tschak909/frob-modern/hardware/docs/board-top.png

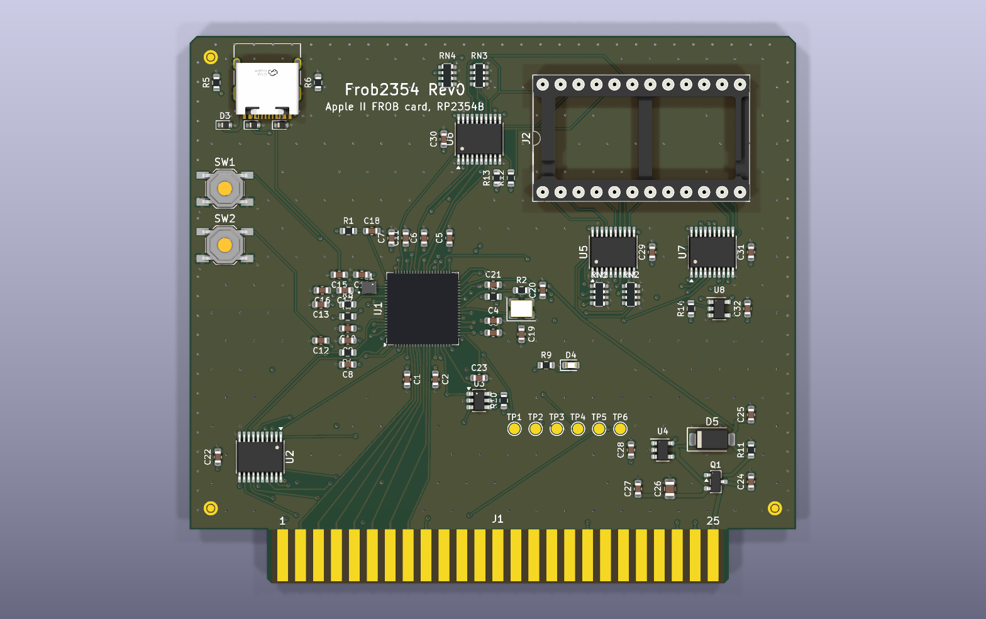
hardware/docs/board-top.png
