tschak909/frob-modern/hardware/docs/board-bottom.png

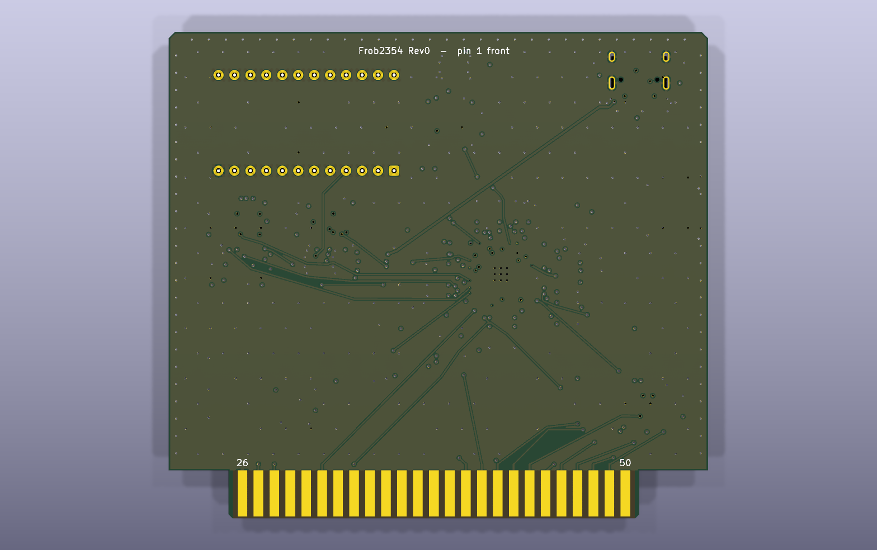
hardware/docs/board-bottom.png
