tschak909/frob-modern/hardware/Frob2354-BOM.csv

Refs | Value | Footprint | MPN | LCSC | Description | Assembly
C1,C2,C3,C4,C5,C6,C7,C8,C9,C10,C11,C14,C15,C16,C21,C22,C23,C24,C29,C30,C31,C32 | 100nF | C_0603_1608Metric | CC0603KRX7R9BB104 | C14663 | IOVDD decoupling | JLCPCB
C12,C28 | 10uF | C_0603_1608Metric | CL10A106KP8NNNC | C19702 | 3.3V bulk at the RP | JLCPCB
C13,C17,C18 | 4.7uF | C_0603_1608Metric | CL10A475KO8NNNC | C19666 | VREG_VIN bulk | JLCPCB
C19,C20 | 15pF | C_0603_1608Metric | CL10C150JB8NNNC | C1644 | crystal load | JLCPCB
C25,C27 | 1uF | C_0603_1608Metric | CL10A105KB8NNNC | C15849 | VBUS decoupling | JLCPCB
C26 | 22uF | C_0805_2012Metric | CL21A226MAQNNNE | C45783 | +5V bulk | JLCPCB
D1,D2,D3 | ESD5Z5.0T1G | D_SOD-523 | ESD5Z5.0T1G | C82044 | USB ESD | JLCPCB
D4 | green | LED_0603_1608Metric | KT-0603G | C12624 | status LED (GP22) | JLCPCB
D5 | SS34 | D_SMA | SS34 | C8678 | USB VBUS OR-ing (no back-feed into the Apple) | JLCPCB
J2 | FROB cable | DIP-24_W15.24mm_Socket | 110-43-624-41-001000 |  | 2600 cable socket, DIP-24 0.6 in (original FROB J2 pin-out); hand-solder | hand-solder
J3 | USB-C | USB_C_Receptacle_HRO_TYPE-C-31-M-12 | TYPE-C-31-M-12 | C165948 | firmware update / bench power | JLCPCB
L1 | 3.3uH | RPI_L_AOTA-B201610S3R3 | AOTA-B201610S3R3-101-T | C42411119 | RP2350 core SMPS inductor | JLCPCB
Q1 | AO3401A | SOT-23 | AO3401A | C15127 | slot 5V switch: G = VBUS, S = +5V, D = SLOT_5V | JLCPCB
R1 | 33R | R_0603_1608Metric | 0603WAF330JT5E | C23140 | VREG_AVDD filter | JLCPCB
R2,R4,R9 | 1k | R_0603_1608Metric | 0603WAF1001T5E | C21190 | crystal drive limit | JLCPCB
R3,R10,R12,R13,R14 | 10k | R_0603_1608Metric | 0603WAF1002T5E | C25804 | RUN pull-up | JLCPCB
R5,R6 | 5.1k | R_0603_1608Metric | 0603WAF5101T5E | C23186 | UFP Rd | JLCPCB
R7,R8 | 27R | R_0603_1608Metric | 0603WAF270JT5E | C25190 | USB series | JLCPCB
R11 | 100k | R_0603_1608Metric | 0603WAF1003T5E | C25803 | holds the P-FET gate low without USB | JLCPCB
RN1,RN2,RN3,RN4 | 4x100k | R_Array_Convex_4x0603 | 4D03WGJ0104T5E | C1996 | 2600 address pull-downs: defined inputs with the cable unplugged | JLCPCB
SW1 | RESET | SW_SPST_TL3342 | TL3342F160QG | C2886898 | RP2354B reset (RUN) | JLCPCB
SW2 | BOOTSEL | SW_SPST_TL3342 | TL3342F160QG | C2886898 | RP2354B BOOTSEL: hold while pressing RESET (or plugging USB) for the UF2 drive | JLCPCB
U1 | RP2354B | QFN-80-1EP_10x10mm_P0.4mm_EP3.4x3.4mm | RP2354B | C39843328 | RP2350B + 2MB flash: FROB RAM, control/status and mailbox registers, both buses | JLCPCB
U2,U5,U6,U7 | 74LVC245A | TSSOP-20_4.4x6.5mm_P0.65mm | SN74LVC245APWR | C7848 | Apple D0-D7 buffer: DIR = R/W, enabled only during this slot's /IOSEL or /DEVSEL | JLCPCB
U3 | 74LVC1G0832 | SOT-23-6 | SN74LVC1G0832DBVR | C206101 | Apple buffer /OE = (/IOSEL & /DEVSEL) | A2_DOE_N | JLCPCB
U4 | AP2112K-3.3 | SOT-23-5 | AP2112K-3.3TRG1 | C51118 | 3.3V LDO, 600mA, fast start: every 3.3V load | JLCPCB
U8 | 74LVC1G32 | SOT-23-5 | SN74LVC1G32DBVR | C10096 | 2600 data buffer /OE = /CE | V_DOE_N | JLCPCB
Y1 | 12MHz | Crystal_SMD_3225-4Pin_3.2x2.5mm | ABM8-272-T3 | C20625731 |  | JLCPCB
