tschak909/frob-modern/hardware/3d/C_0805_2012Metric.step

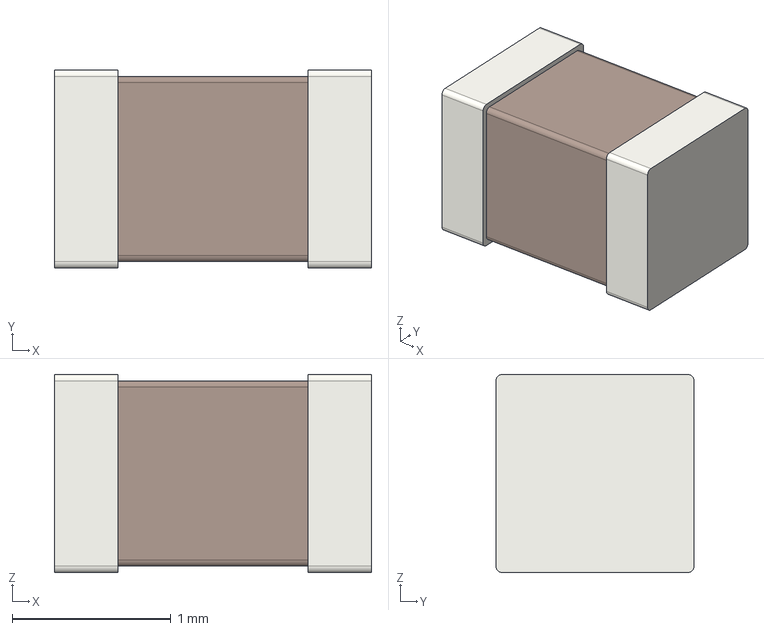
[picture p3: CAD file, 2026-10-03]
hardware/3d/C_0805_2012Metric.step
2.00 x 1.25 x 1.25 mm
