tschak909/frob-modern/hardware/3d/D_SMA.step

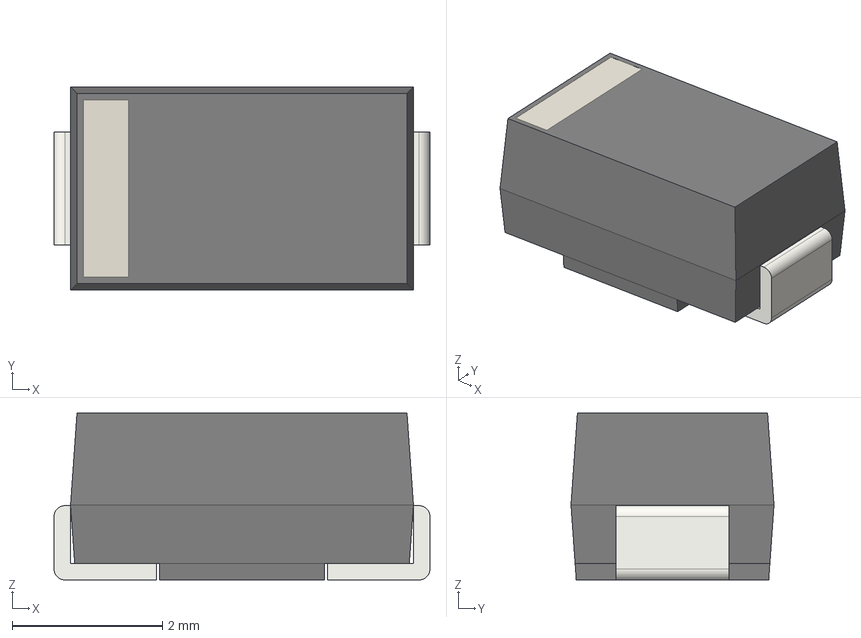
[picture p4: CAD file, 2026-10-03]
hardware/3d/D_SMA.step
5.00 x 2.70 x 2.22 mm
