tschak909/frob-modern/hardware/3d/DIP-24_W15.24mm_Socket.step

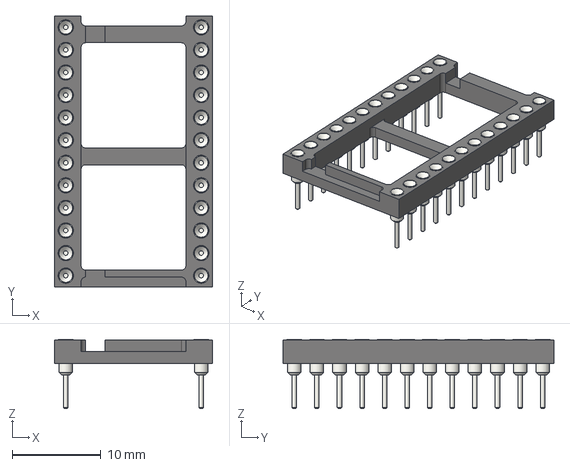
[picture p5: CAD file, 2026-10-03]
hardware/3d/DIP-24_W15.24mm_Socket.step
17.8 x 30.5 x 7.79 mm
