tschak909/frob-modern/hardware/3d/SOT-23.step

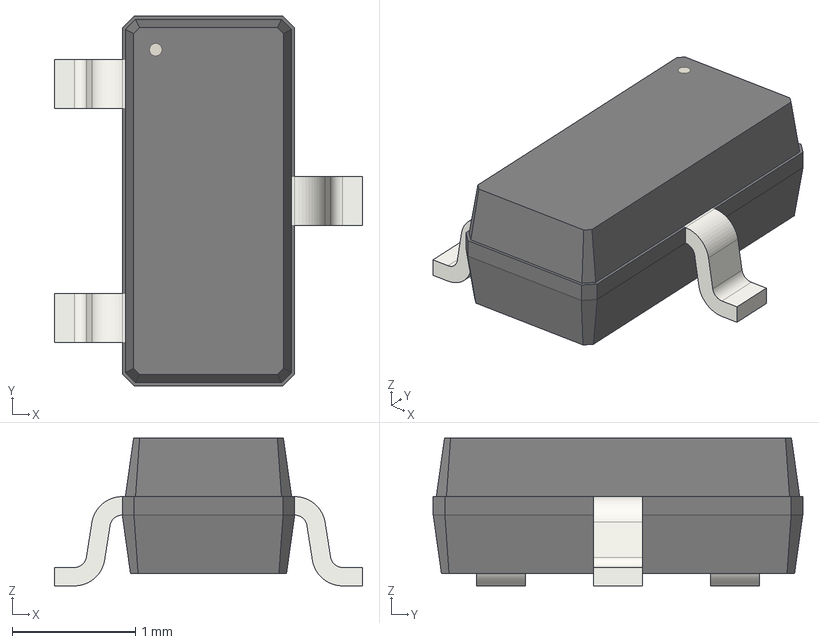
[picture p6: CAD file, 2026-10-03]
hardware/3d/SOT-23.step
2.50 x 3.00 x 1.20 mm
