tschak909/frob-modern/hardware/3d/R_Array_Convex_4x0603.step

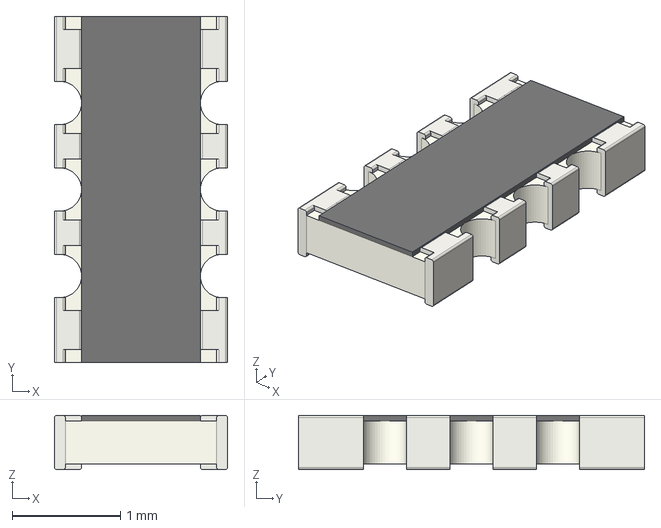
[picture p7: CAD file, 2026-10-03]
hardware/3d/R_Array_Convex_4x0603.step
1.60 x 3.20 x 0.5 mm
