tschak909/frob-modern/hardware/3d/SW_SPST_TL3342.step

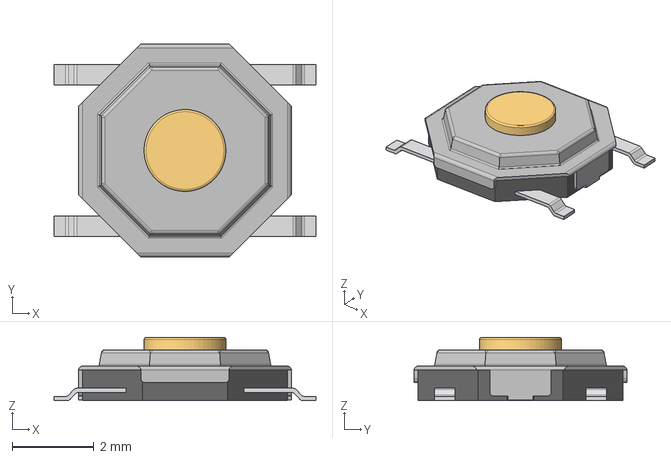
[picture p9: CAD file, 2026-10-03]
hardware/3d/SW_SPST_TL3342.step
6.40 x 5.20 x 1.54 mm
