tschak909/frob-modern/hardware/3d/USB-C_HRO_TYPE-C-31-M-12.step

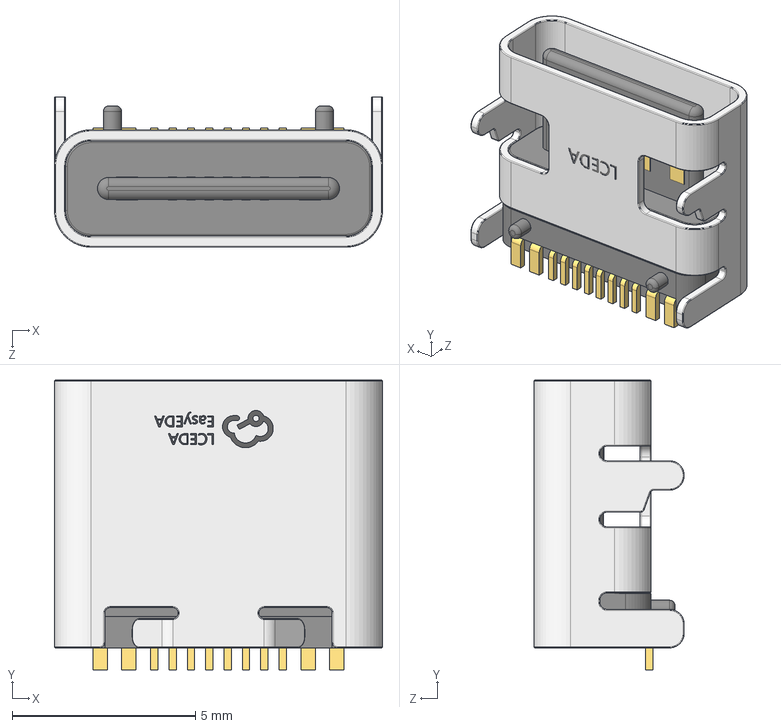
[picture p10: CAD file, 2026-10-03]
hardware/3d/USB-C_HRO_TYPE-C-31-M-12.step
8.94 x 7.90 x 4.10 mm
