tschak909/frob-modern/hardware/3d/R_0603_1608Metric.step

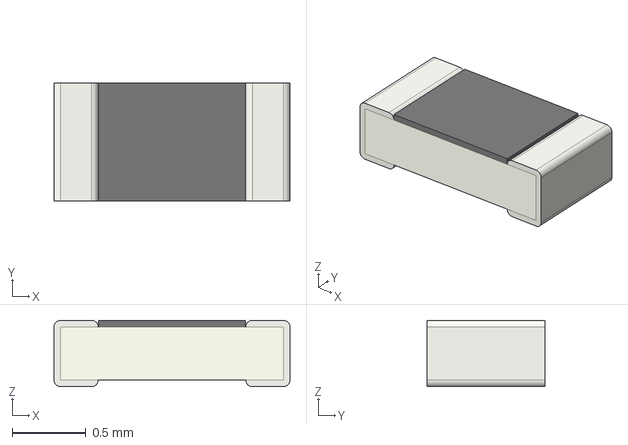
[picture p11: CAD file, 2026-10-03]
hardware/3d/R_0603_1608Metric.step
1.60 x 0.8 x 0.45 mm
