tschak909/frob-modern/hardware/3d/SOT-23-6.step

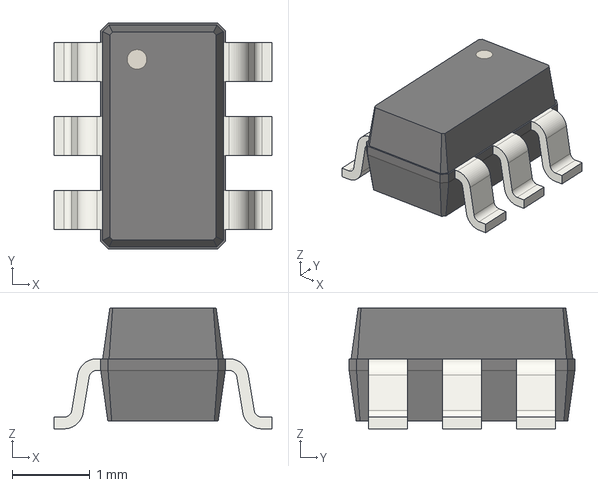
[picture p12: CAD file, 2026-10-03]
hardware/3d/SOT-23-6.step
2.80 x 2.90 x 1.55 mm
