tschak909/frob-modern/hardware/3d/TSSOP-20_4.4x6.5mm_P0.65mm.step

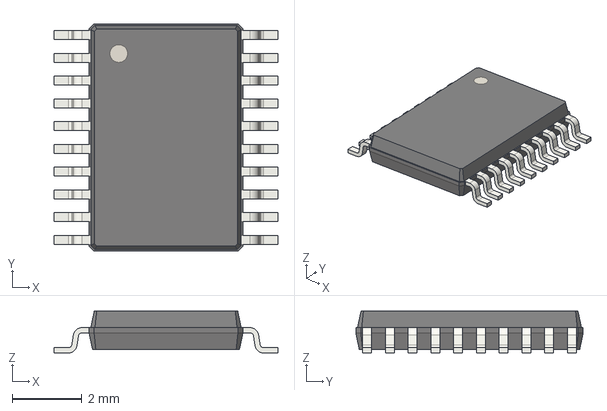
[picture p13: CAD file, 2026-10-03]
hardware/3d/TSSOP-20_4.4x6.5mm_P0.65mm.step
6.40 x 6.50 x 1.20 mm
