tschak909/frob-modern/hardware/3d/SOT-23-5.step

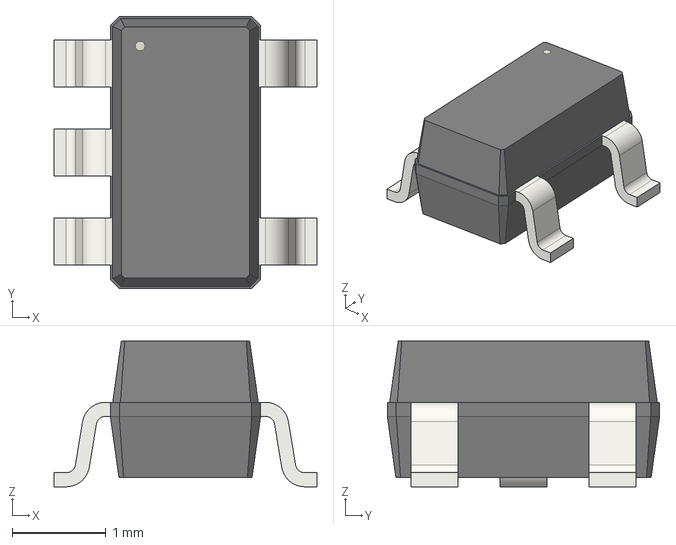
[picture p14: CAD file, 2026-10-03]
hardware/3d/SOT-23-5.step
2.80 x 2.90 x 1.55 mm
