tschak909/frob-modern/hardware/3d/AOTA-B201610S3R3.step

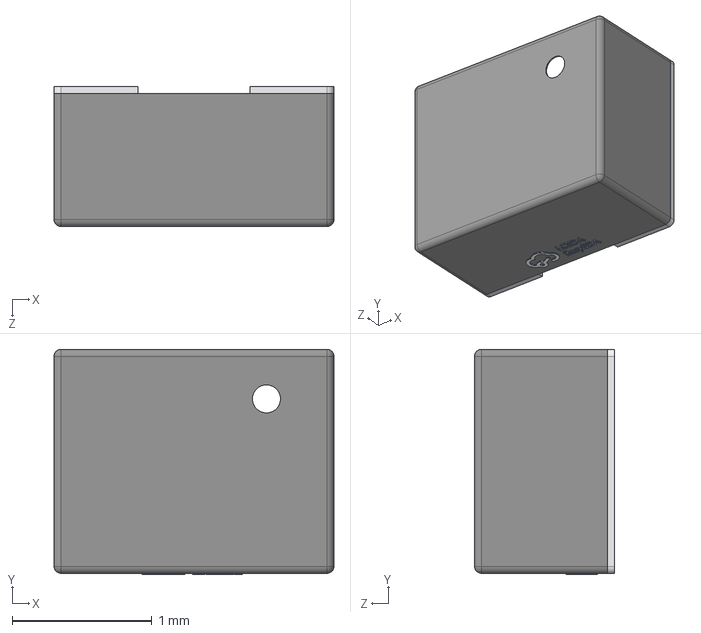
[picture p15: CAD file, 2026-10-03]
hardware/3d/AOTA-B201610S3R3.step
2.00 x 1.61 x 1.00 mm
