tschak909/frob-modern/hardware/3d/LED_0603_1608Metric.step

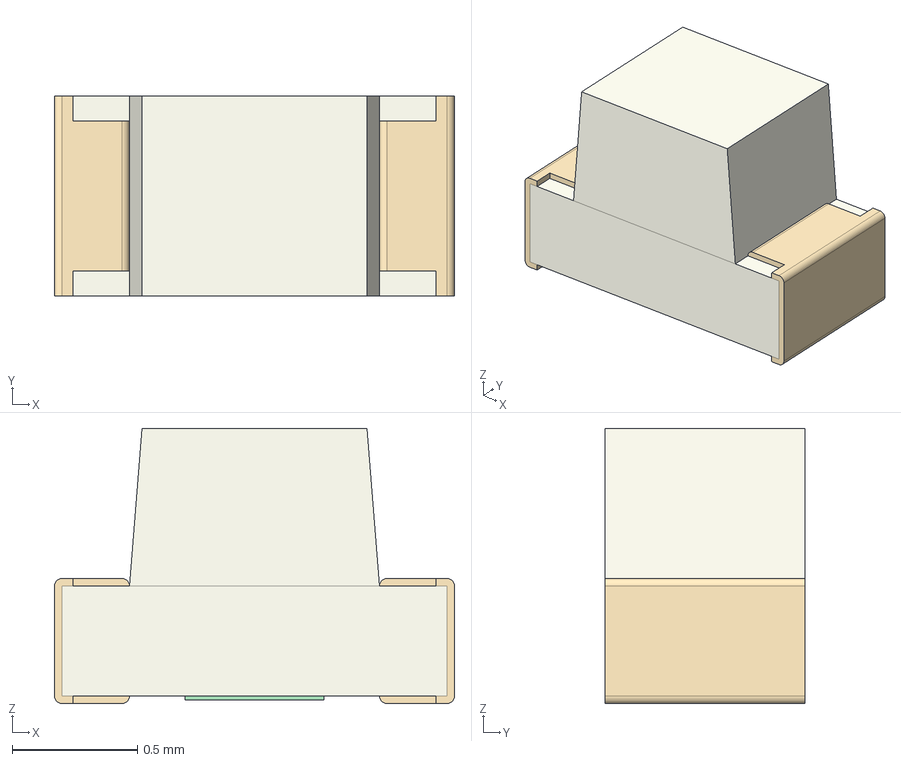
[picture p16: CAD file, 2026-10-03]
hardware/3d/LED_0603_1608Metric.step
1.60 x 0.8 x 1.10 mm
