tschak909/frob-modern/hardware/3d/D_SOD-523.step

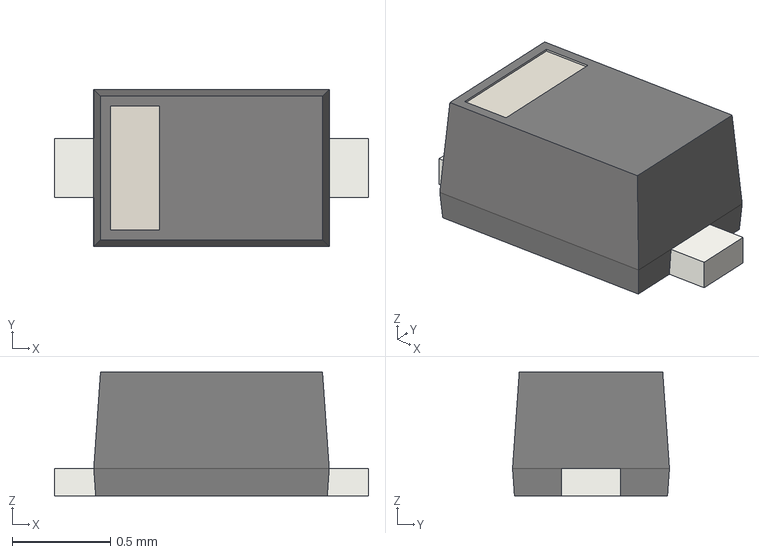
[picture p17: CAD file, 2026-10-03]
hardware/3d/D_SOD-523.step
1.60 x 0.8 x 0.63 mm
