tschak909/frob-modern/hardware/3d/Crystal_SMD_3225-4Pin_3.2x2.5mm.step

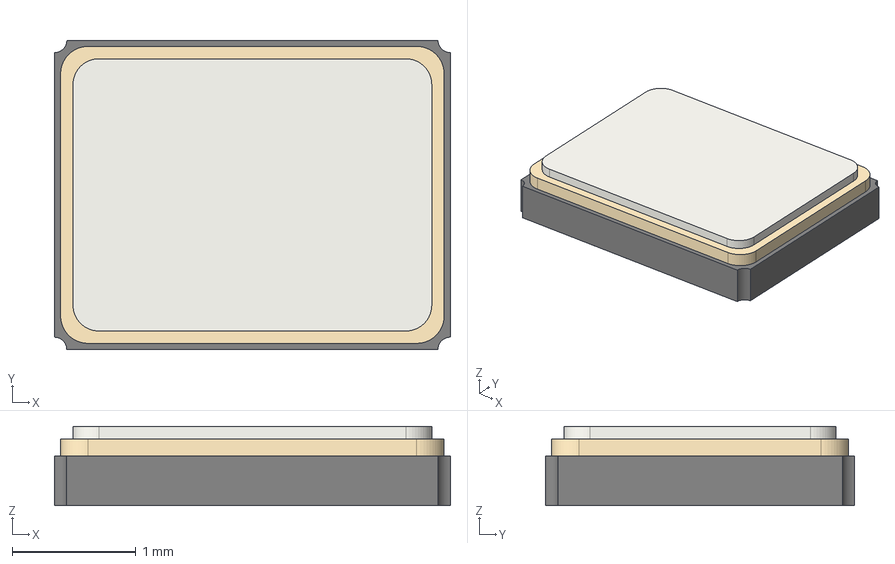
[picture p18: CAD file, 2026-10-03]
hardware/3d/Crystal_SMD_3225-4Pin_3.2x2.5mm.step
3.20 x 2.50 x 0.64 mm
