tschak909/frob-modern/hardware/docs/Frob2354-schematic.pdf

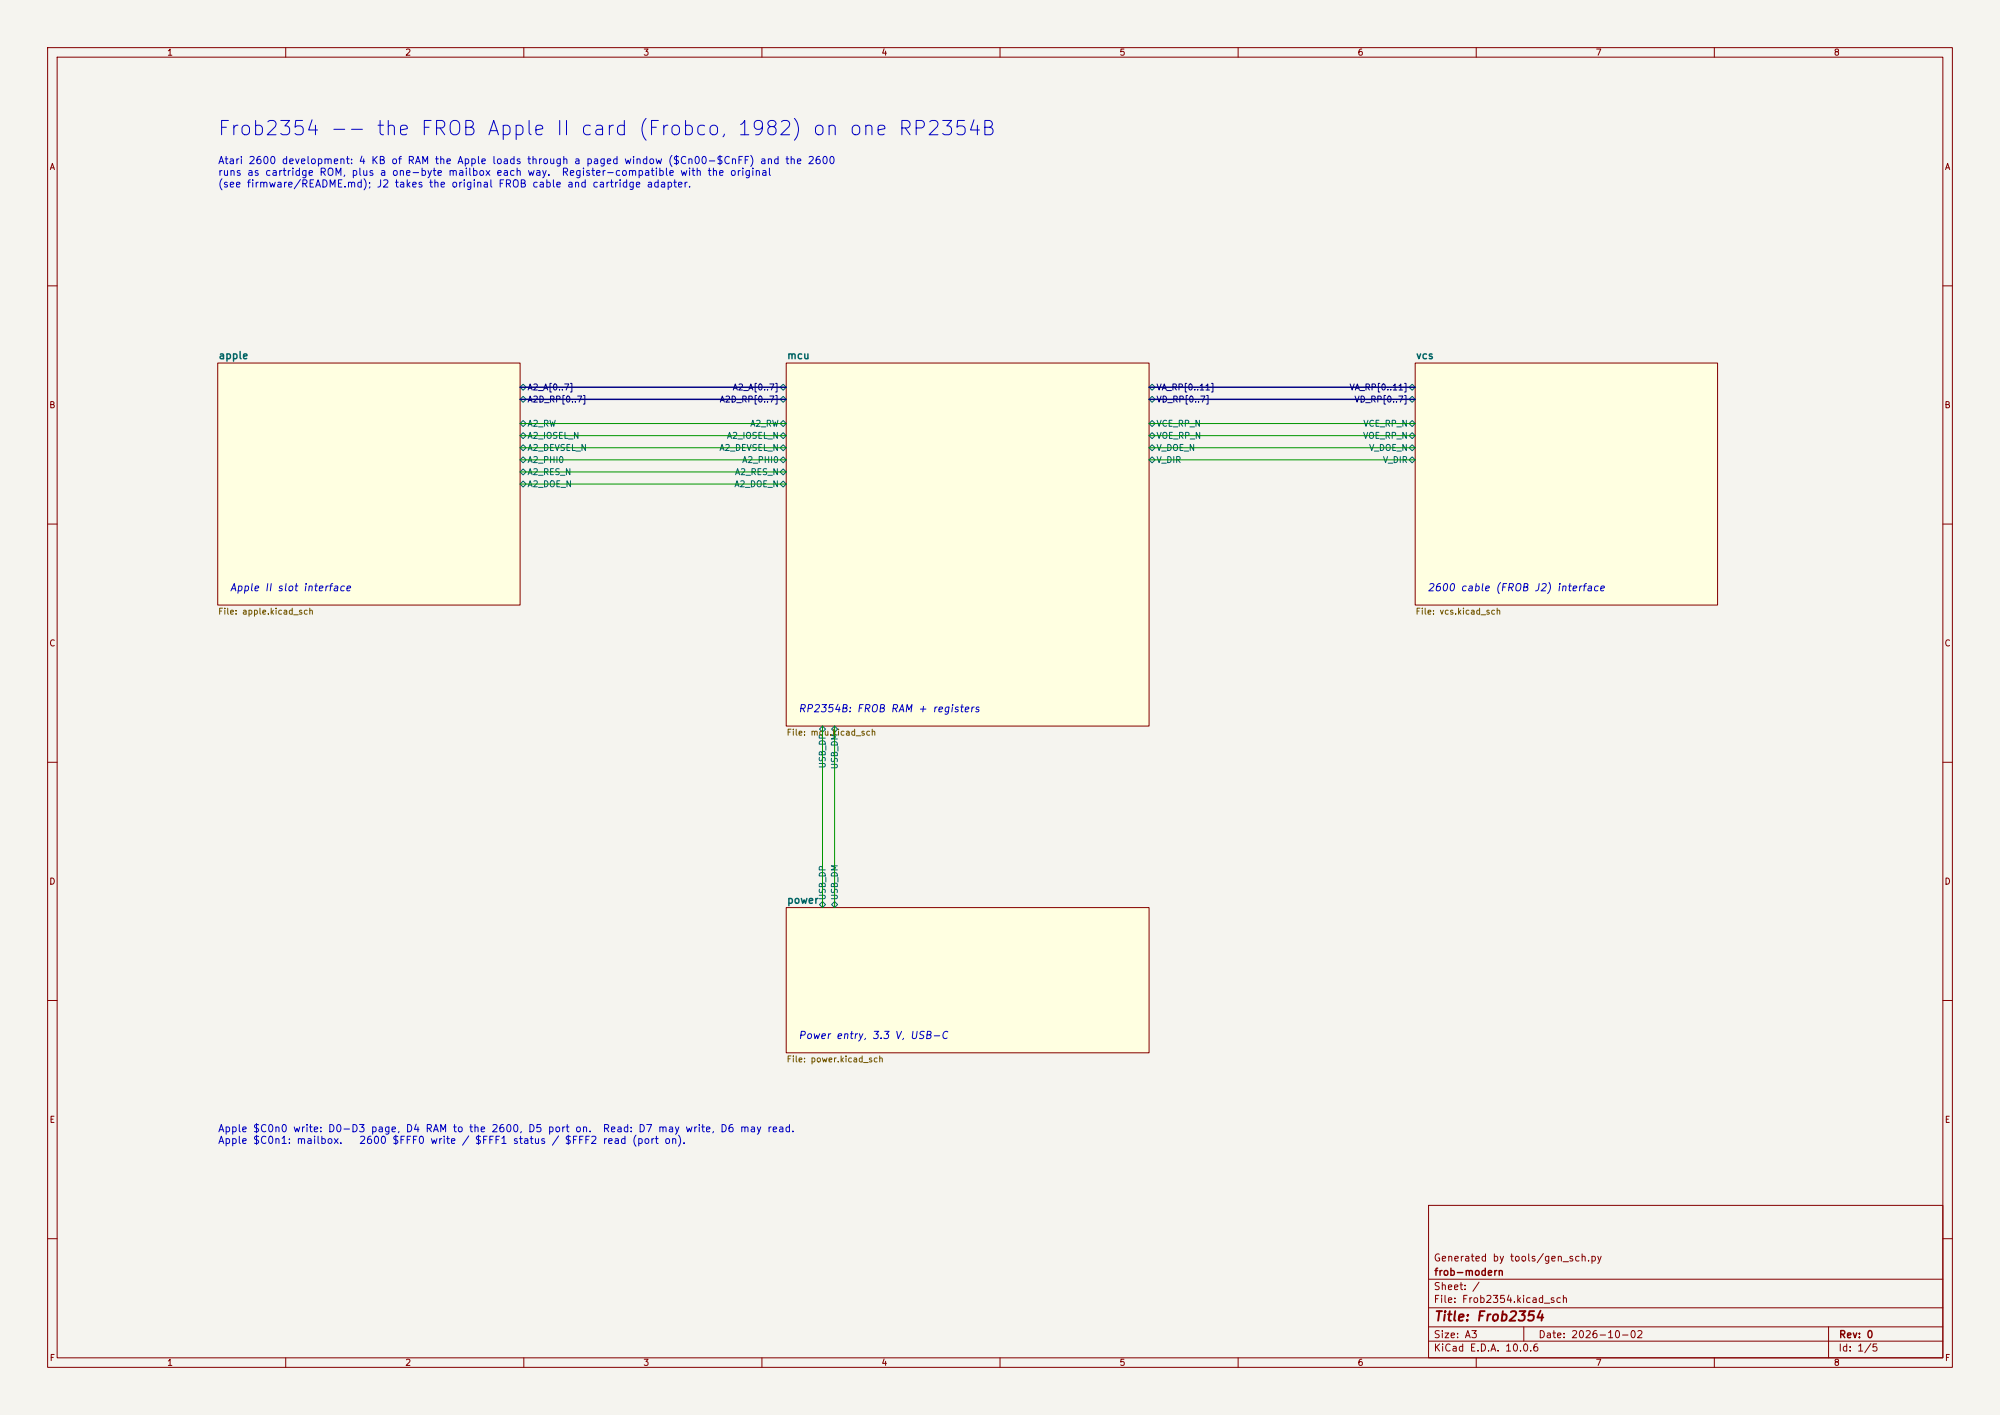
[picture p19: page 1]

Frob2354 -- the FROB Apple II card (Frobco, 1982) on one RP2354B

Atari 2600 development: 4 KB of RAM the Apple loads through a paged window ($Cn00-$CnFF) and the 2600
runs as cartridge ROM, plus a one-byte mailbox each way. Register-compatible with the original
(see firmware/README.md); J2 takes the original FROB cable and cartridge adapter.

A2D_RP[0..7] A2_RW | VD_RP[0..7] VCE_RP_N

A2_IOSEL_N | VOE_RP_N
A2_DEVSEL_N A2_DEVSEL_N A2_PHI0 A2_PHI0 | V_DOE_N

RP2354B: FROB RAM + registers
File: mcu.kicad_sch USB_DP USB_DM power File: power.kicad_sch

Apple $C0n0 write: D0-D3 page, D4 RAM to the 2600, D5 port on. Read: D7 may write, D6 may read.

Size: A3 | Rev: 0 | F Date: 2026-10-02
KiCad E.D.A. 10.0.6 | Id: 1/5

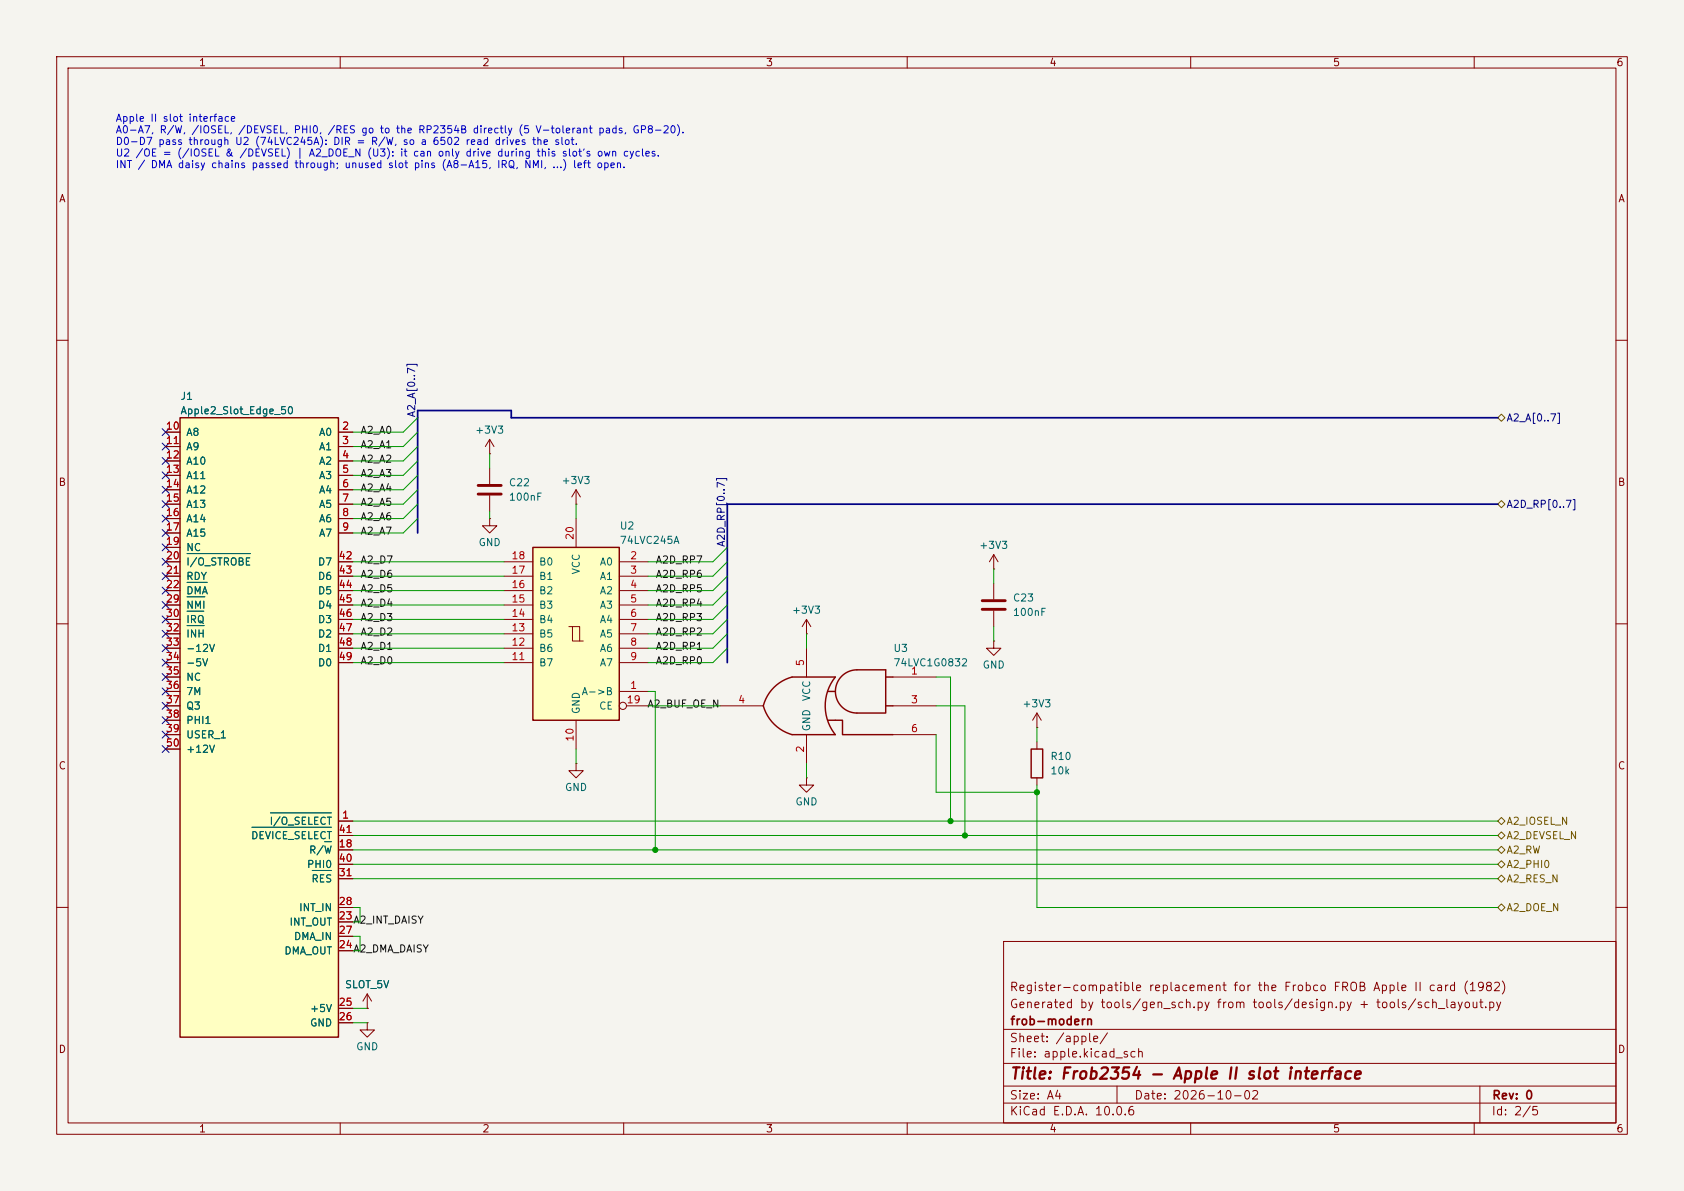
[picture p20: page 2]

Apple II slot interface
A0-A7, R/W, /IOSEL, /DEVSEL, PHI0, /RES go to the RP2354B directly (5 V-tolerant pads, GP8-20). D0-D7 pass through U2 (74LVC245A): DIR = R/W, so a 6502 read drives the slot. U2 /OE = (/IOSEL & /DEVSEL) | A2_DOE_N (U3): it can only drive during this slot's own cycles.

INT / DMA daisy chains passed through; unused slot pins (A8-A15, IRQ, NMI, ...) left open. J1

Register-compatible replacement for the Frobco FROB Apple II card (1982) C23

Generated by tools/gen_sch.py from tools/design.py + tools/sch_layout.py
frob-modern
Sheet: /apple/
File: apple.kicad_sch
Title: Frob2354 - Apple II slot interface

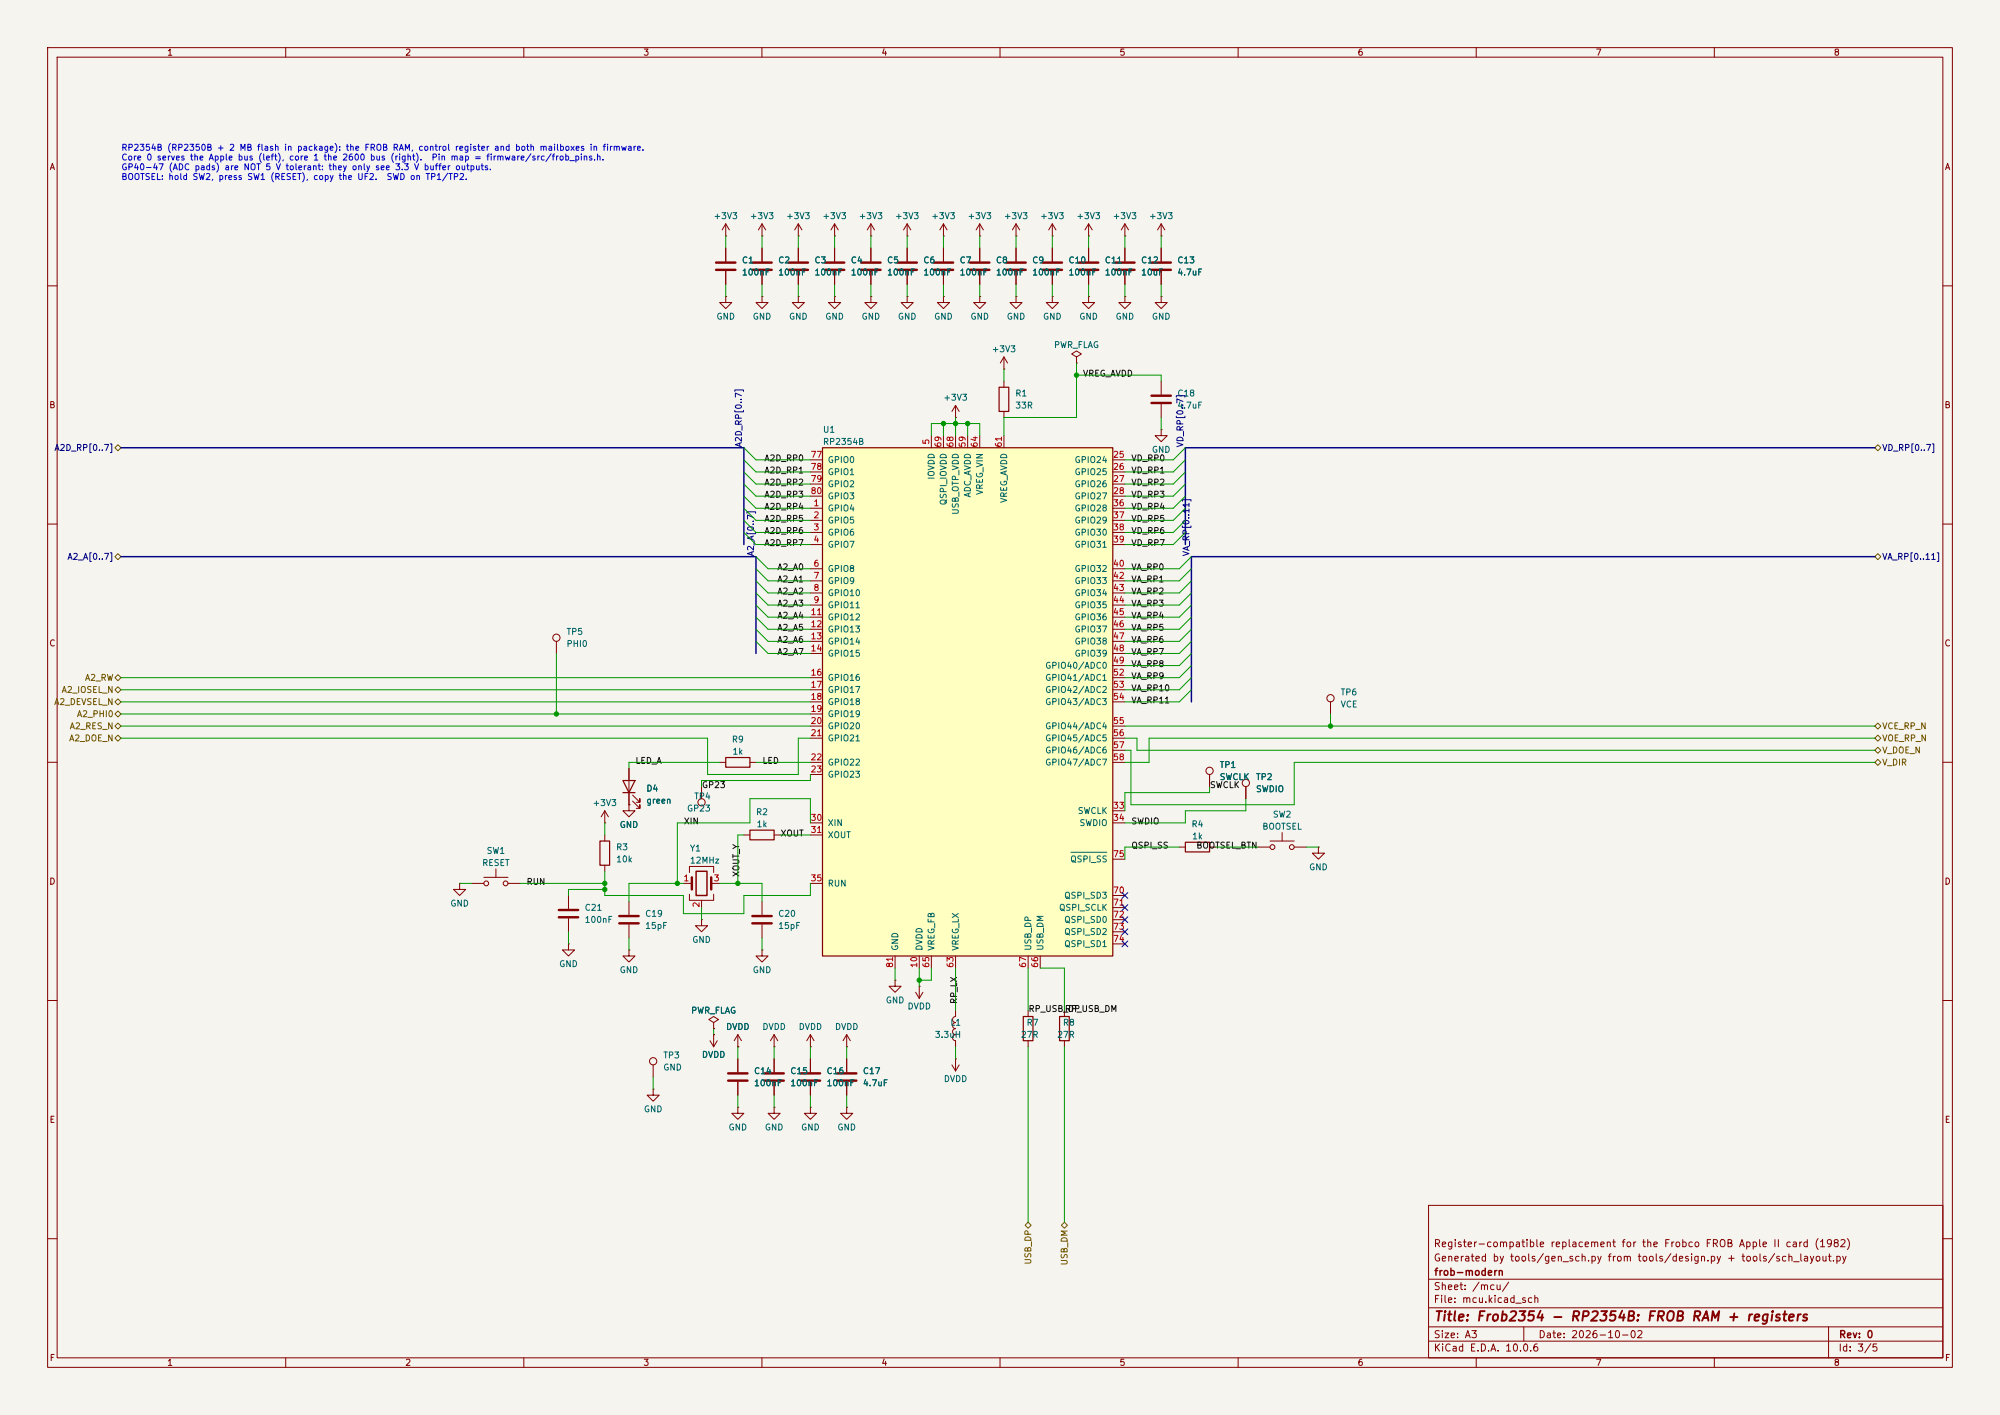
[picture p21: page 3]

A2D_RP5 RP2354B (RP2350B + 2 MB flash in package): the FROB RAM, control register and both mailboxes in firmware. Core 0 serves the Apple bus (left), core 1 the 2600 bus (right). Pin map = firmware/src/frob_pins.h. GP40-47 (ADC pads) are NOT 5 V tolerant: they only see 3.3 V buffer outputs. BOOTSEL: hold SW2, press SW1 (RESET), copy the UF2. SWD on TP1/TP2.

Register-compatible replacement for the Frobco FROB Apple II card (1982) GND
DVDD

Generated by tools/gen_sch.py from tools/design.py + tools/sch_layout.py
frob-modern
Sheet: /mcu/
File: mcu.kicad_sch
Title: Frob2354 - RP2354B: FROB RAM + registers

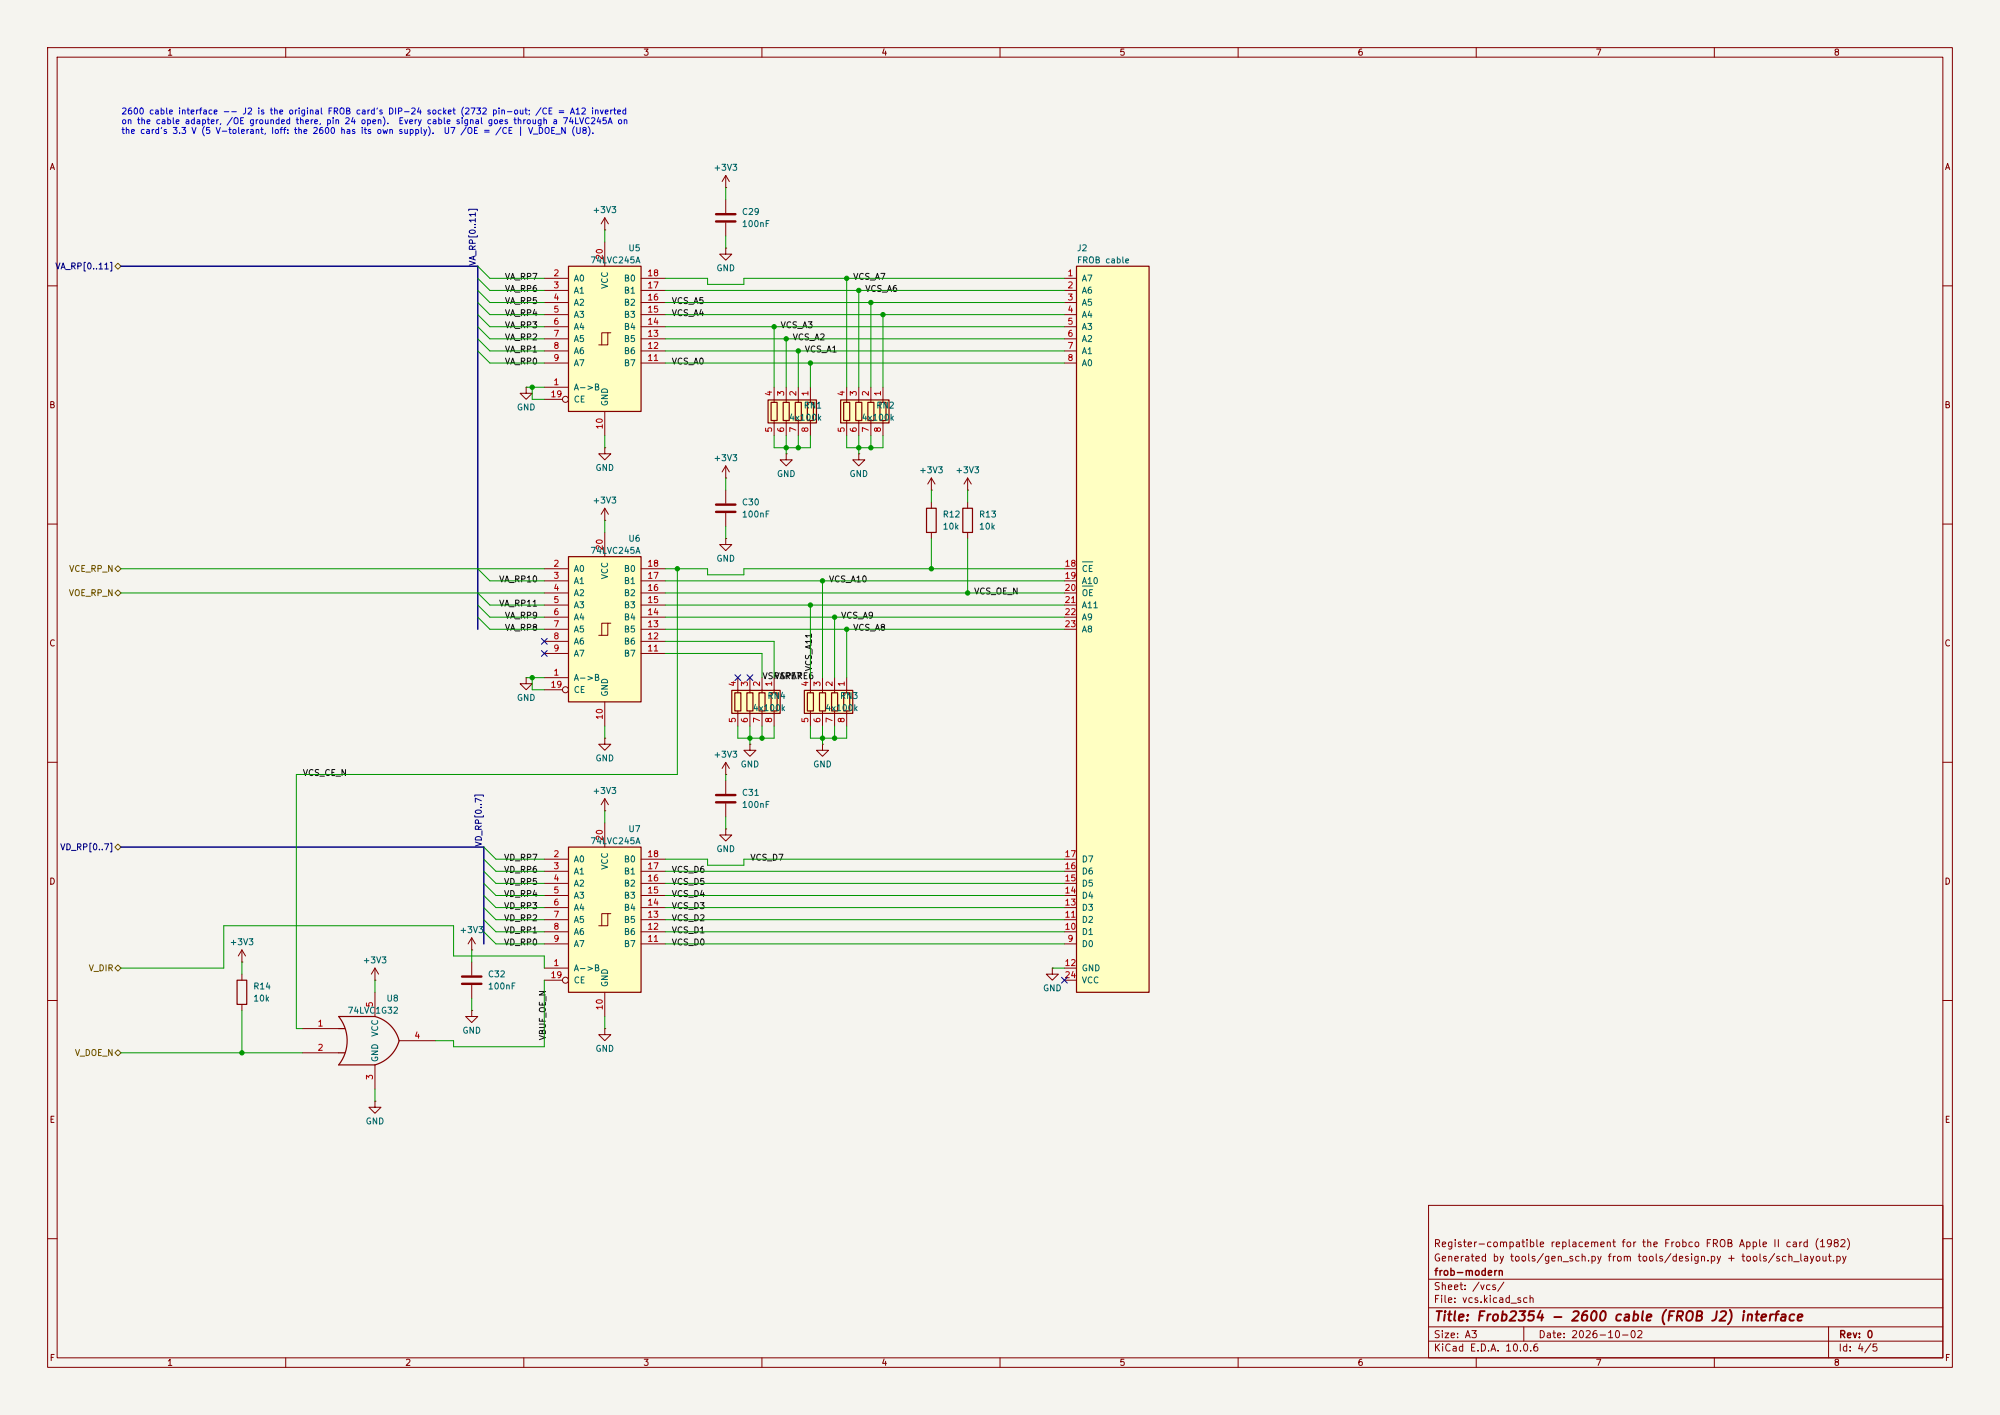
[picture p22: page 4]

2600 cable interface -- J2 is the original FROB card's DIP-24 socket (2732 pin-out; /CE = A12 inverted
on the cable adapter, /OE grounded there, pin 24 open). Every cable signal goes through a 74LVC245A on
the card's 3.3 V (5 V-tolerant, Ioff: the 2600 has its own supply). U7 /OE = /CE | V_DOE_N (U8).

FROB cable R13 A1 7

VCS_A5 | A5 3
VCS_A4 | | A4 4

A3 5
A2 6

74LVC1G32
Register-compatible replacement for the Frobco FROB Apple II card (1982) 1

Generated by tools/gen_sch.py from tools/design.py + tools/sch_layout.py
frob-modern
Sheet: /vcs/
File: vcs.kicad_sch
Title: Frob2354 - 2600 cable (FROB J2) interface

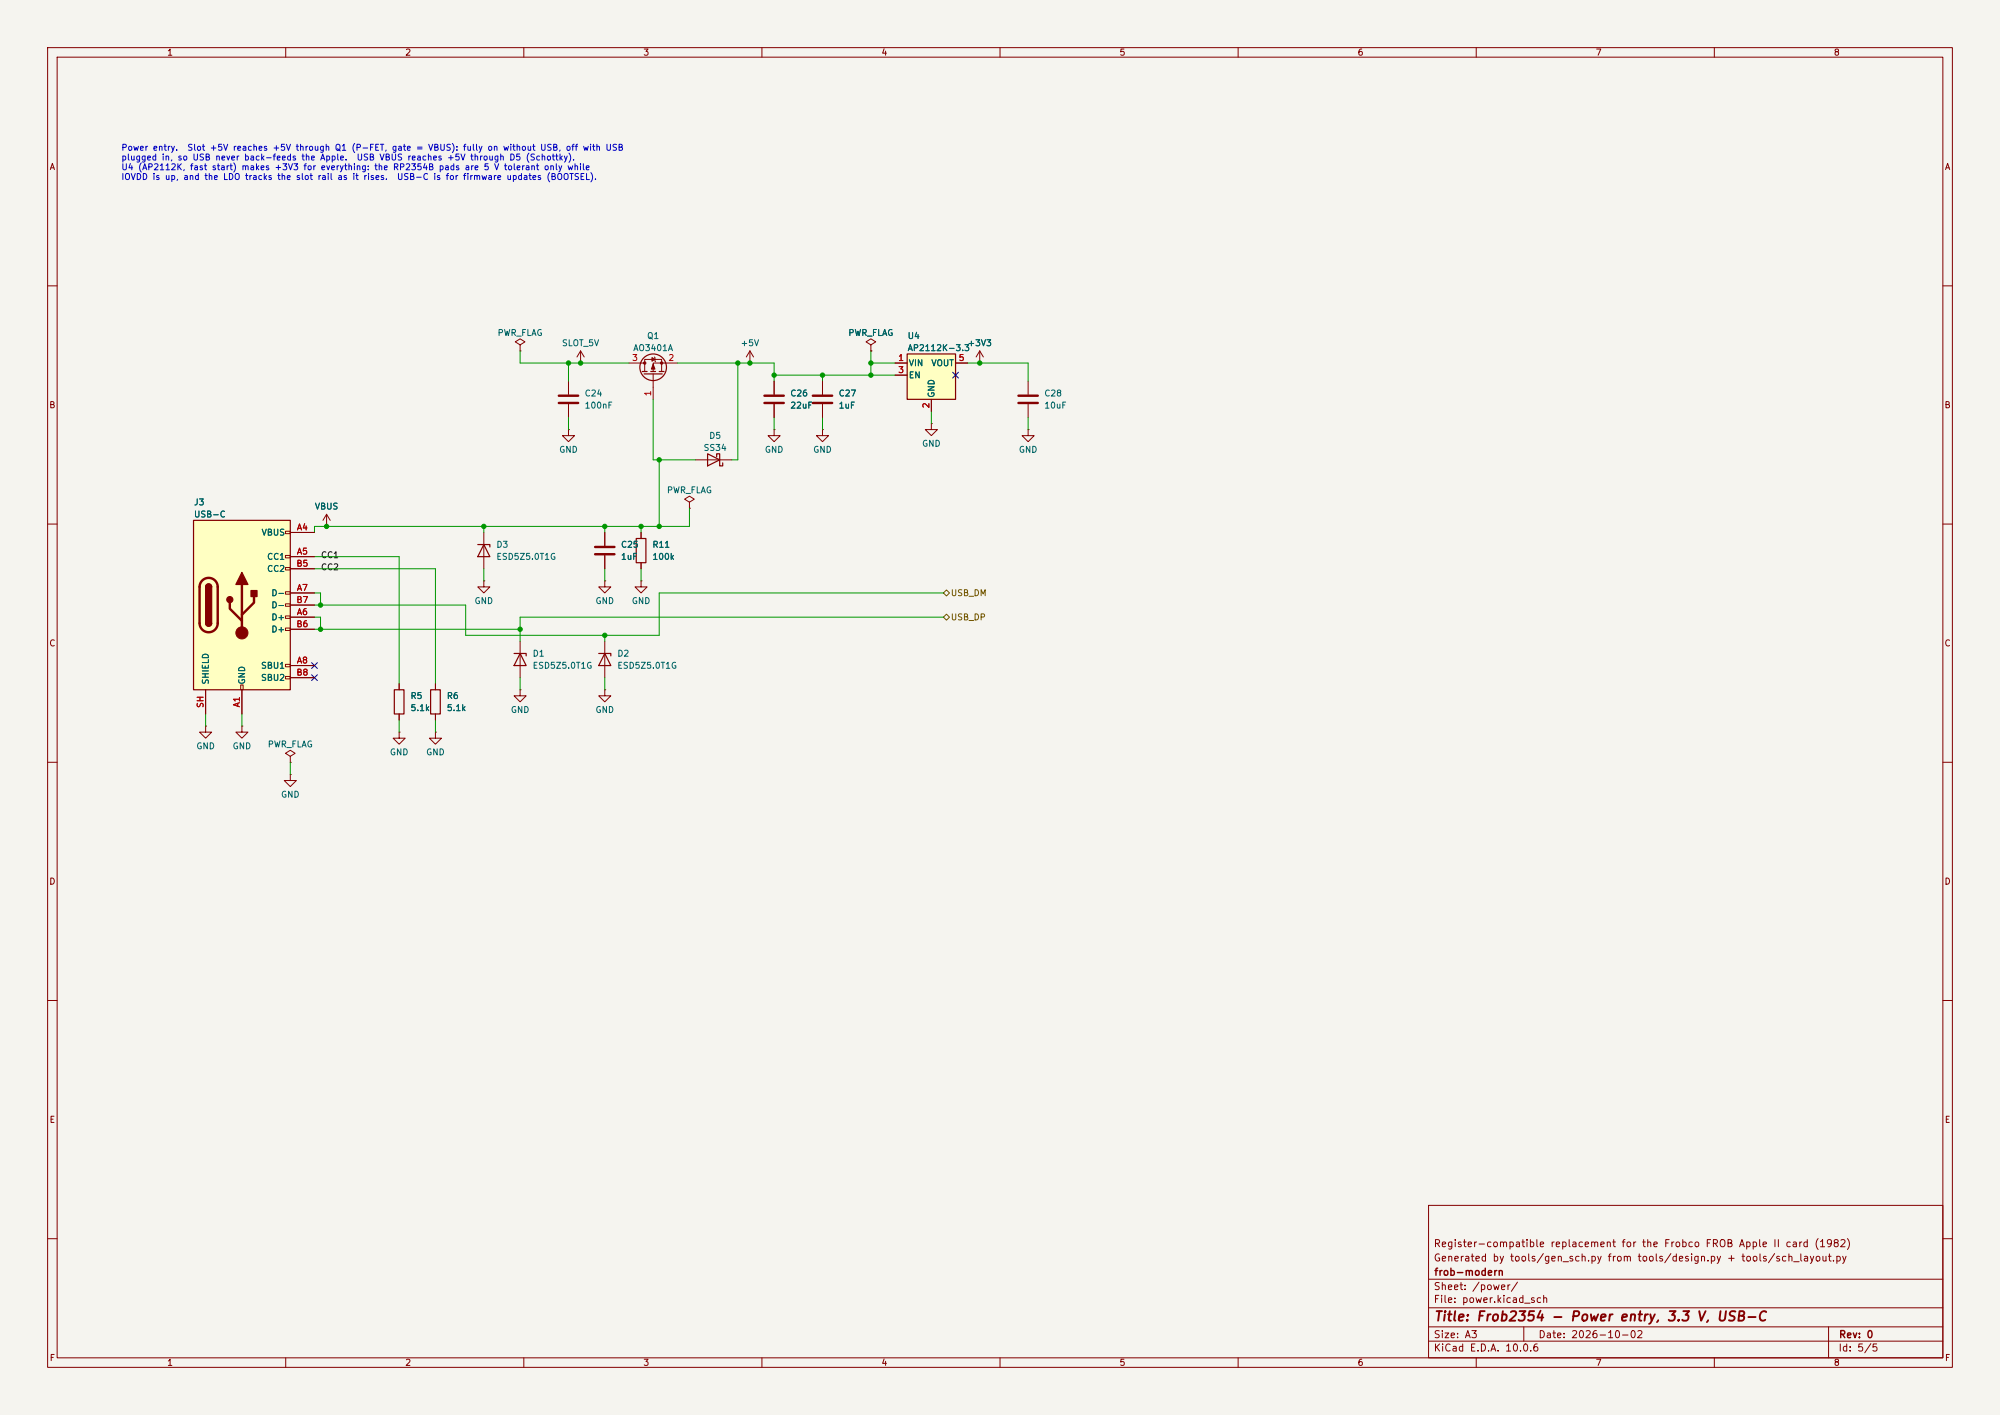
[picture p23: page 5]

CC2 CC1 Power entry. Slot +5V reaches +5V through Q1 (P-FET, gate = VBUS): fully on without USB, off with USB
plugged in, so USB never back-feeds the Apple. USB VBUS reaches +5V through D5 (Schottky). U4 (AP2112K, fast start) makes +3V3 for everything: the RP2354B pads are 5 V tolerant only while

Register-compatible replacement for the Frobco FROB Apple II card (1982)
Generated by tools/gen_sch.py from tools/design.py + tools/sch_layout.py
frob-modern
Sheet: /power/
File: power.kicad_sch
Title: Frob2354 - Power entry, 3.3 V, USB-C
