tschak909/frob-modern/hardware/Frob2354.kicad_pcb

## KiCad design hardware/Frob2354.kicad_pcb (2026-10-03)

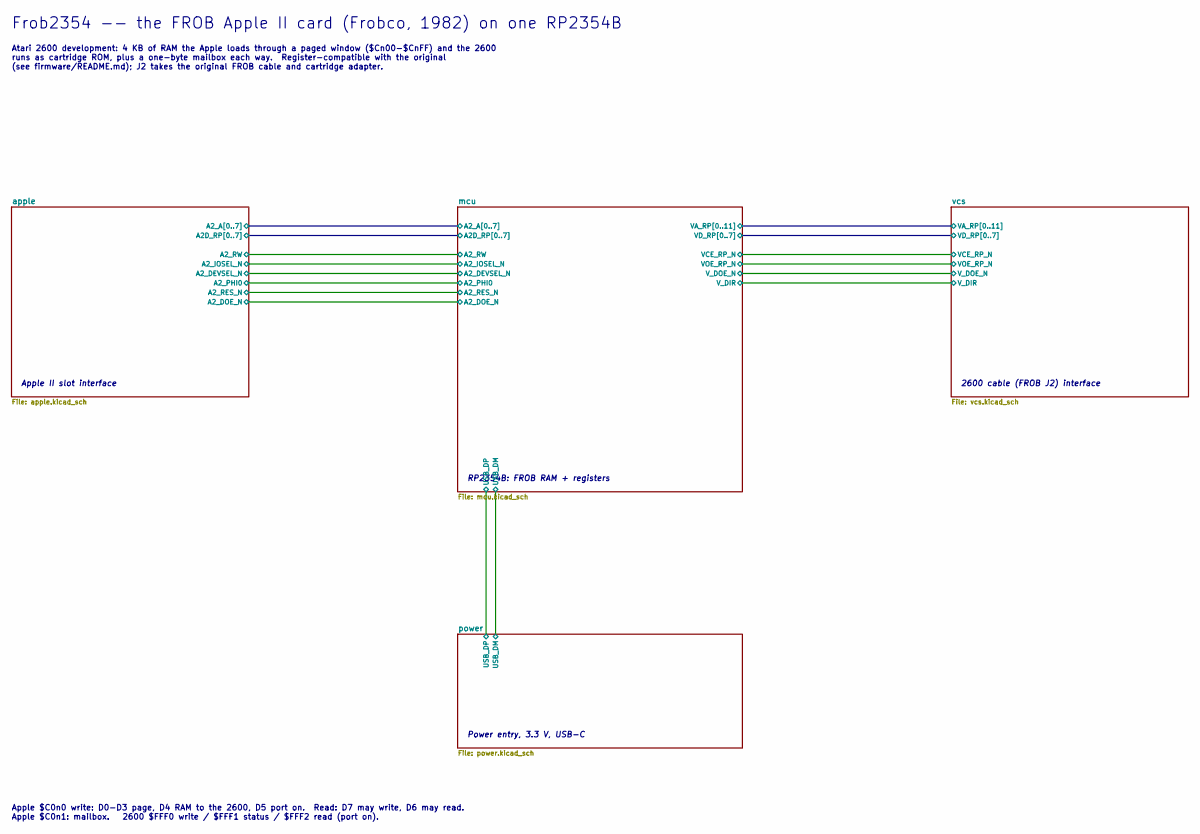
[picture p24: schematic Frob2354.kicad_sch]

Notes on the sheet:
Apple II slot interface
RP2354B: FROB RAM + registers
2600 cable (FROB J2) interface
Power entry, 3.3 V, USB-C
Frob2354 -- the FROB Apple II card (Frobco, 1982) on one RP2354B
Atari 2600 development: 4 KB of RAM the Apple loads through a paged window ($Cn00-$CnFF) and the 2600 runs as cartridge ROM, plus a one-byte mailbox each way. Register-compatible with the original (see firmware/README.md); J2 takes the original FROB cable and cartridge adapter.
Apple $C0n0 write: D0-D3 page, D4 RAM to the 2600, D5 port on. Read: D7 may write, D6 may read. Apple $C0n1: mailbox. 2600 $FFF0 write / $FFF1 status / $FFF2 read (port on).

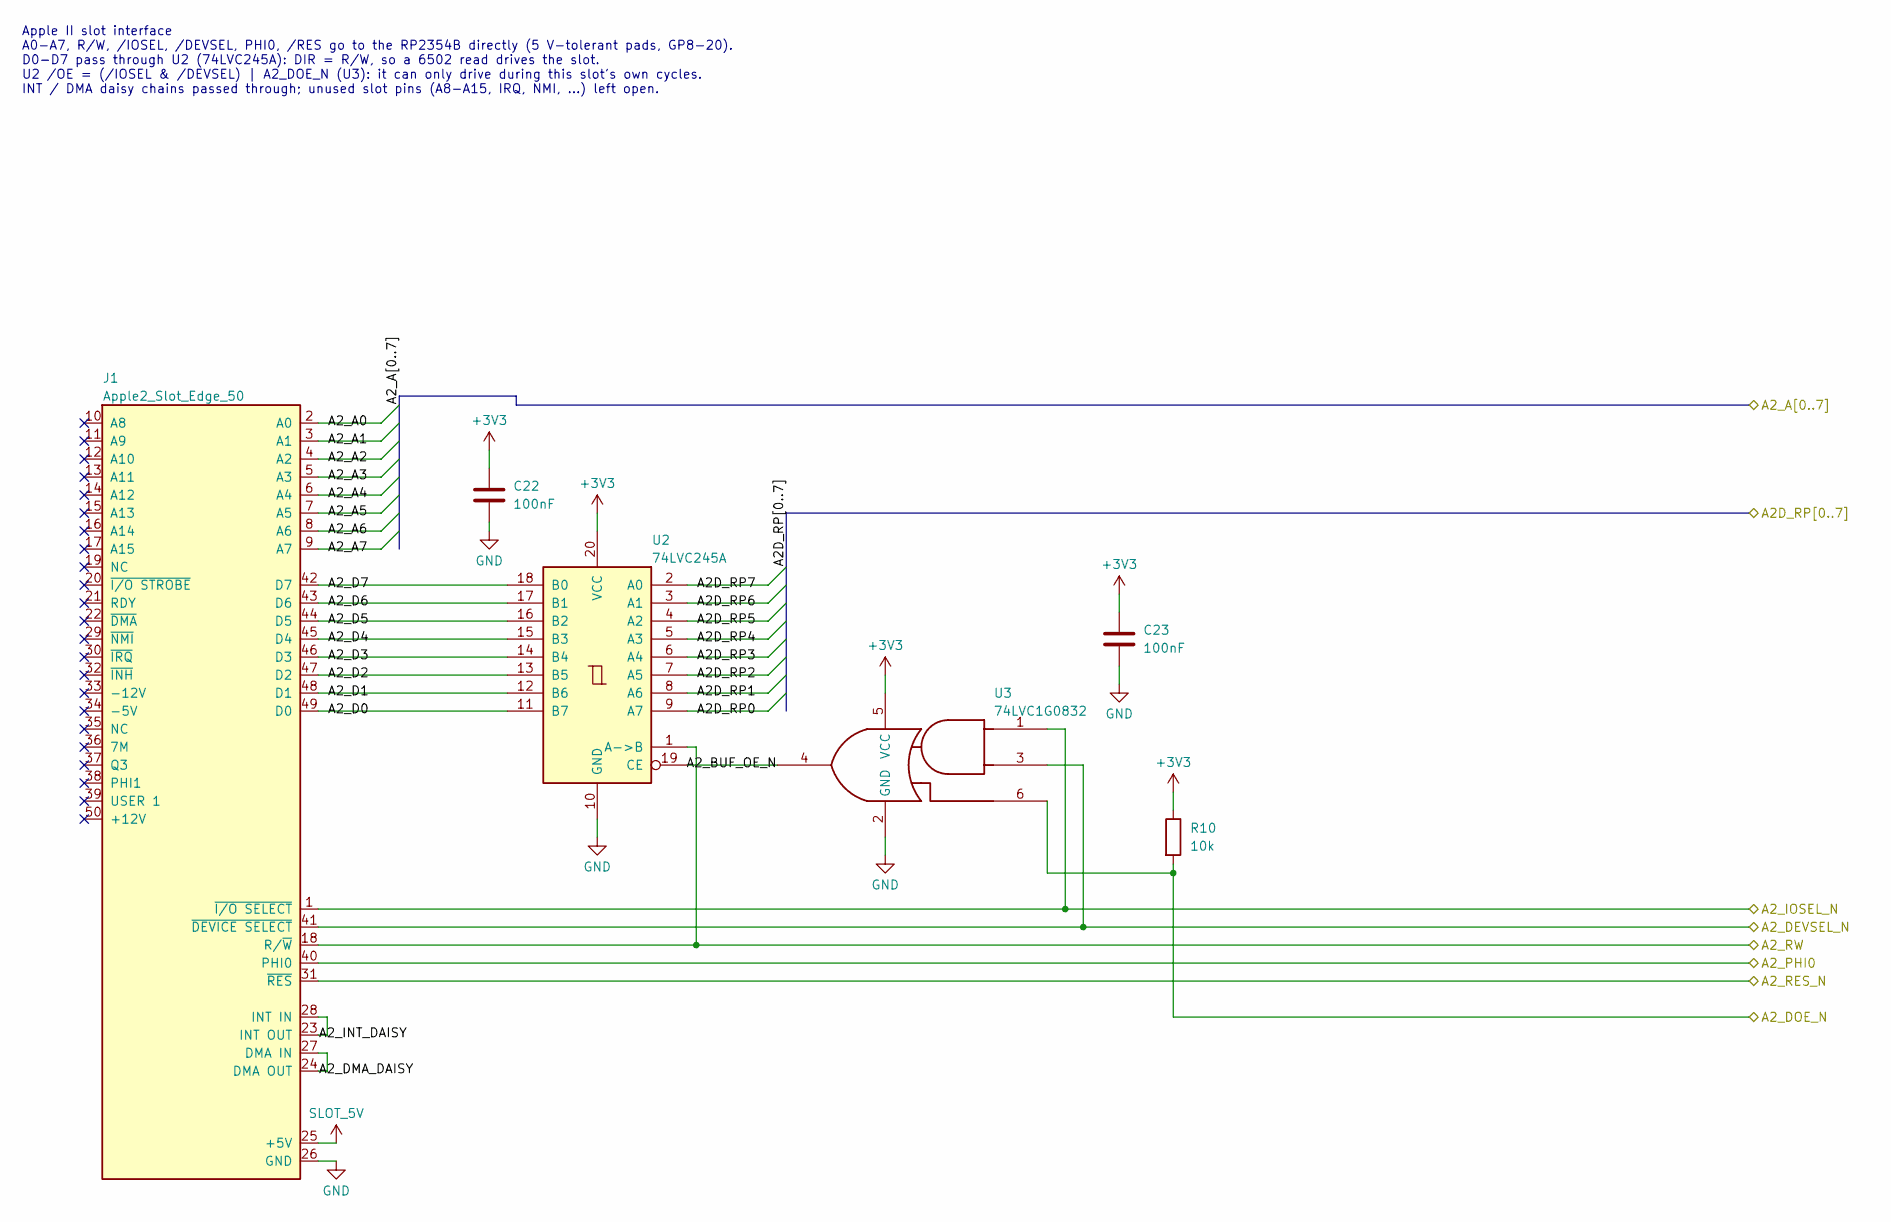
[picture p25: schematic apple.kicad_sch, Frob2354 - Apple II slot interface]

Parts:
C22, C23: 100nF; C_0603_1608Metric; MPN CC0603KRX7R9BB104; LCSC C14663
J1: Apple2_Slot_Edge_50
R10: 10k; R_0603_1608Metric; MPN 0603WAF1002T5E; LCSC C25804
U2: 74LVC245A; TSSOP-20_4.4x6.5mm_P0.65mm; MPN SN74LVC245APWR; LCSC C7848
U3: 74LVC1G0832; SOT-23-6; MPN SN74LVC1G0832DBVR; LCSC C206101

Connections:
+3V3: C22.1, C23.1, R10.1, U2.20 (VCC), U3.5 (VCC); also elsewhere on the board
/apple/A2D_RP0: U2.9 (A7); also elsewhere on the board
/apple/A2D_RP1: U2.8 (A6); also elsewhere on the board
/apple/A2D_RP2: U2.7 (A5); also elsewhere on the board
/apple/A2D_RP3: U2.6 (A4); also elsewhere on the board
/apple/A2D_RP4: U2.5 (A3); also elsewhere on the board
/apple/A2D_RP5: U2.4 (A2); also elsewhere on the board
/apple/A2D_RP6: U2.3 (A1); also elsewhere on the board
/apple/A2D_RP7: U2.2 (A0); also elsewhere on the board
/apple/A2_A0: J1.2 (A0); also elsewhere on the board
/apple/A2_A1: J1.3 (A1); also elsewhere on the board
/apple/A2_A2: J1.4 (A2); also elsewhere on the board
/apple/A2_A3: J1.5 (A3); also elsewhere on the board
/apple/A2_A4: J1.6 (A4); also elsewhere on the board
/apple/A2_A5: J1.7 (A5); also elsewhere on the board
/apple/A2_A6: J1.8 (A6); also elsewhere on the board
/apple/A2_A7: J1.9 (A7); also elsewhere on the board
/apple/A2_BUF_OE_N: U2.19 (CE), U3.4
/apple/A2_D0: J1.49 (D0), U2.11 (B7)
/apple/A2_D1: J1.48 (D1), U2.12 (B6)
/apple/A2_D2: J1.47 (D2), U2.13 (B5)
/apple/A2_D3: J1.46 (D3), U2.14 (B4)
/apple/A2_D4: J1.45 (D4), U2.15 (B3)
/apple/A2_D5: J1.44 (D5), U2.16 (B2)
/apple/A2_D6: J1.43 (D6), U2.17 (B1)
/apple/A2_D7: J1.42 (D7), U2.18 (B0)
/apple/A2_DEVSEL_N: J1.41 (~DEVICE SELECT), U3.3; also elsewhere on the board
/apple/A2_DMA_DAISY: J1.24 (DMA OUT), J1.27 (DMA IN)
/apple/A2_DOE_N: R10.2, U3.6; also elsewhere on the board
/apple/A2_INT_DAISY: J1.23 (INT OUT), J1.28 (INT IN)
/apple/A2_IOSEL_N: J1.1 (~I/O SELECT), U3.1; also elsewhere on the board
/apple/A2_PHI0: J1.40 (PHI0); also elsewhere on the board
/apple/A2_RES_N: J1.31 (~RES); also elsewhere on the board
/apple/A2_RW: J1.18 (R/~W), U2.1 (A->B); also elsewhere on the board
GND: C22.2, C23.2, J1.26 (GND), U2.10 (GND), U3.2 (GND); also elsewhere on the board
SLOT_5V: J1.25 (+5V); also elsewhere on the board

Notes on the sheet:
Apple II slot interface A0-A7, R/W, /IOSEL, /DEVSEL, PHI0, /RES go to the RP2354B directly (5 V-tolerant pads, GP8-20). D0-D7 pass through U2 (74LVC245A): DIR = R/W, so a 6502 read drives the slot. U2 /OE = (/IOSEL & /DEVSEL) | A2_DOE_N (U3): it can only drive during this slot's own cycles. INT / D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

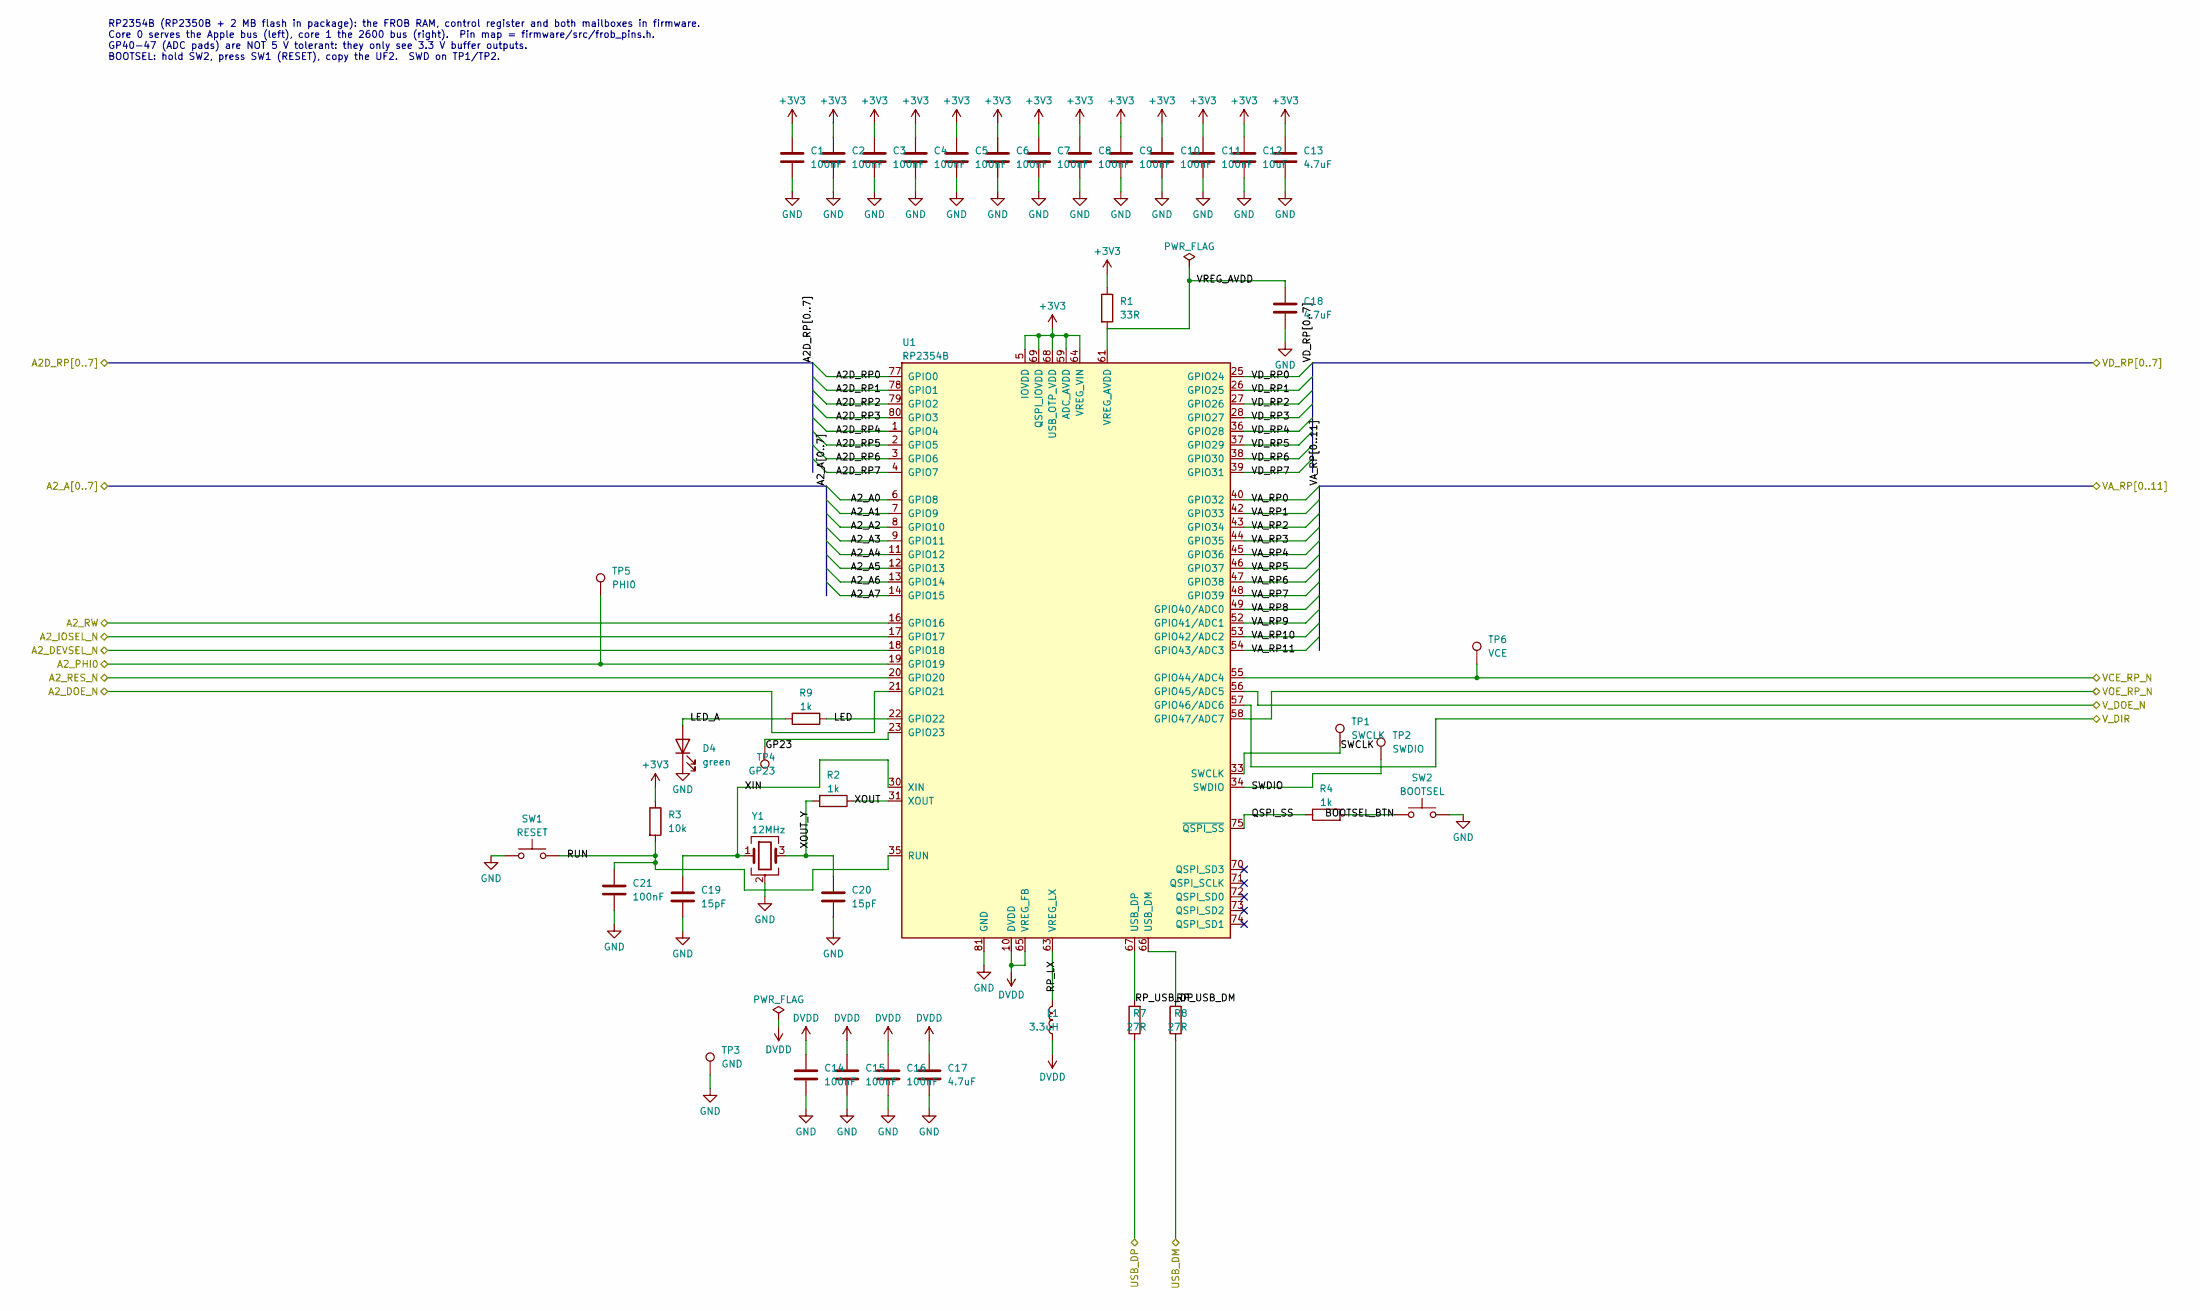
[picture p26: schematic mcu.kicad_sch, Frob2354 - RP2354B: FROB RAM + registers]

Parts:
C1, C2, C3, C4, C5, C6, C7, C8, C9, C10, C11, C14, C15, C16, C21: 100nF; C_0603_1608Metric; MPN CC0603KRX7R9BB104; LCSC C14663
C12: 10uF; C_0603_1608Metric; MPN CL10A106KP8NNNC; LCSC C19702
C13, C17, C18: 4.7uF; C_0603_1608Metric; MPN CL10A475KO8NNNC; LCSC C19666
C19, C20: 15pF; C_0603_1608Metric; MPN CL10C150JB8NNNC; LCSC C1644
D4: green; LED_0603_1608Metric; MPN KT-0603G; LCSC C12624
L1: 3.3uH; RPI_L_AOTA-B201610S3R3; MPN AOTA-B201610S3R3-101-T; LCSC C42411119
R1: 33R; R_0603_1608Metric; MPN 0603WAF330JT5E; LCSC C23140
R2, R4, R9: 1k; R_0603_1608Metric; MPN 0603WAF1001T5E; LCSC C21190
R3: 10k; R_0603_1608Metric; MPN 0603WAF1002T5E; LCSC C25804
R7, R8: 27R; R_0603_1608Metric; MPN 0603WAF270JT5E; LCSC C25190
SW1: RESET; SW_SPST_TL3342; MPN TL3342F160QG; LCSC C2886898
SW2: BOOTSEL; SW_SPST_TL3342; MPN TL3342F160QG; LCSC C2886898
TP1: SWCLK; TestPoint_Pad_D1.5mm
TP2: SWDIO; TestPoint_Pad_D1.5mm
TP3: GND; TestPoint_Pad_D1.5mm
TP4: GP23; TestPoint_Pad_D1.5mm
TP5: PHI0; TestPoint_Pad_D1.5mm
TP6: VCE; TestPoint_Pad_D1.5mm
U1: RP2354B; QFN-80-1EP_10x10mm_P0.4mm_EP3.4x3.4mm; MPN RP2354B; LCSC C39843328
Y1: 12MHz; Crystal_SMD_3225-4Pin_3.2x2.5mm; MPN ABM8-272-T3; LCSC C20625731

Connections:
+3V3: C1.1, C2.1, C3.1, C4.1, C5.1, C6.1, C7.1, C8.1, C9.1, C10.1, C11.1, C12.1, C13.1, R1.1, R3.1, U1.5 (IOVDD), U1.15 (IOVDD), U1.24 (IOVDD), U1.29 (IOVDD), U1.41 (IOVDD), U1.50 (IOVDD), U1.59 (ADC_AVDD), U1.60 (IOVDD), U1.64 (VREG_VIN), U1.68 (USB_OTP_VDD), U1.69 (QSPI_IOVDD), U1.76 (IOVDD); also elsewhere on the board
/apple/A2D_RP0: U1.77 (GPIO0); also elsewhere on the board
/apple/A2D_RP1: U1.78 (GPIO1); also elsewhere on the board
/apple/A2D_RP2: U1.79 (GPIO2); also elsewhere on the board
/apple/A2D_RP3: U1.80 (GPIO3); also elsewhere on the board
/apple/A2D_RP4: U1.1 (GPIO4); also elsewhere on the board
/apple/A2D_RP5: U1.2 (GPIO5); also elsewhere on the board
/apple/A2D_RP6: U1.3 (GPIO6); also elsewhere on the board
/apple/A2D_RP7: U1.4 (GPIO7); also elsewhere on the board
/apple/A2_A0: U1.6 (GPIO8); also elsewhere on the board
/apple/A2_A1: U1.7 (GPIO9); also elsewhere on the board
/apple/A2_A2: U1.8 (GPIO10); also elsewhere on the board
/apple/A2_A3: U1.9 (GPIO11); also elsewhere on the board
/apple/A2_A4: U1.11 (GPIO12); also elsewhere on the board
/apple/A2_A5: U1.12 (GPIO13); also elsewhere on the board
/apple/A2_A6: U1.13 (GPIO14); also elsewhere on the board
/apple/A2_A7: U1.14 (GPIO15); also elsewhere on the board
/apple/A2_DEVSEL_N: U1.18 (GPIO18); also elsewhere on the board
/apple/A2_DOE_N: U1.21 (GPIO21); also elsewhere on the board
/apple/A2_IOSEL_N: U1.17 (GPIO17); also elsewhere on the board
/apple/A2_PHI0: TP5.1, U1.19 (GPIO19); also elsewhere on the board
/apple/A2_RES_N: U1.20 (GPIO20); also elsewhere on the board
/apple/A2_RW: U1.16 (GPIO16); also elsewhere on the board
/mcu/BOOTSEL_BTN: R4.2, SW2.1
/mcu/GP23: TP4.1, U1.23 (GPIO23)
/mcu/LED: R9.1, U1.22 (GPIO22)
/mcu/LED_A: D4.2 (A), R9.2
/mcu/QSPI_SS: R4.1, U1.75 (~QSPI_SS)
/mcu/RP_LX: L1.2, U1.63 (VREG_LX)
/mcu/RP_USB_DM: R8.2, U1.66 (USB_DM)
/mcu/RP_USB_DP: R7.2, U1.67 (USB_DP)
/mcu/RUN: C21.1, R3.2, SW1.1, U1.35 (RUN)
/mcu/SWCLK: TP1.1, U1.33 (SWCLK)
/mcu/SWDIO: TP2.1, U1.34 (SWDIO)
/mcu/USB_DM: R8.1; also elsewhere on the board
/mcu/USB_DP: R7.1; also elsewhere on the board
/mcu/VA_RP0: U1.40 (GPIO32); also elsewhere on the board
/mcu/VA_RP1: U1.42 (GPIO33); also elsewhere on the board
/mcu/VA_RP2: U1.43 (GPIO34); also elsewhere on the board
/mcu/VA_RP3: U1.44 (GPIO35); also elsewhere on the board
/mcu/VA_RP4: U1.45 (GPIO36); also elsewhere on the board
/mcu/VA_RP5: U1.46 (GPIO37); also elsewhere on the board
/mcu/VA_RP6: U1.47 (GPIO38); also elsewhere on the board
/mcu/VA_RP7: U1.48 (GPIO39); also elsewhere on the board
/mcu/VA_RP8: U1.49 (GPIO40/ADC0); also elsewhere on the board
/mcu/VA_RP9: U1.52 (GPIO41/ADC1); also elsewhere on the board
/mcu/VA_RP10: U1.53 (GPIO42/ADC2); also elsewhere on the board
/mcu/VA_RP11: U1.54 (GPIO43/ADC3); also elsewhere on the board
/mcu/VCE_RP_N: TP6.1, U1.55 (GPIO44/ADC4); also elsewhere on the board
/mcu/VD_RP0: U1.25 (GPIO24); also elsewhere on the board
/mcu/VD_RP1: U1.26 (GPIO25); also elsewhere on the board
/mcu/VD_RP2: U1.27 (GPIO26); also elsewhere on the board
/mcu/VD_RP3: U1.28 (GPIO27); also elsewhere on the board
/mcu/VD_RP4: U1.36 (GPIO28); also elsewhere on the board
/mcu/VD_RP5: U1.37 (GPIO29); also elsewhere on the board
/mcu/VD_RP6: U1.38 (GPIO30); also elsewhere on the board
/mcu/VD_RP7: U1.39 (GPIO31); also elsewhere on the board
/mcu/VOE_RP_N: U1.58 (GPIO47/ADC7); also elsewhere on the board
/mcu/VREG_AVDD: C18.1, R1.2, U1.61 (VREG_AVDD)
/mcu/V_DIR: U1.57 (GPIO46/ADC6); also elsewhere on the board
/mcu/V_DOE_N: U1.56 (GPIO45/ADC5); also elsewhere on the board
/mcu/XIN: C19.1, U1.30 (XIN), Y1.1
/mcu/XOUT: R2.1, U1.31 (XOUT)
/mcu/XOUT_Y: C20.1, R2.2, Y1.3
DVDD: C14.1, C15.1, C16.1, C17.1, L1.1, U1.10 (DVDD), U1.32 (DVDD), U1.51 (DVDD), U1.65 (VREG_FB)
GND: C1.2, C2.2, C3.2, C4.2, C5.2, C6.2, C7.2, C8.2, C9.2, C10.2, C11.2, C12.2, C13.2, C14.2, C15.2, C16.2, C17.2, C18.2, C19.2, C20.2, C21.2, D4.1 (K), SW1.2, SW2.2, TP3.1, U1.62 (VREG_PGND), U1.81 (GND), Y1.2 (G), Y1.4 (G); also elsewhere on the board

Notes on the sheet:
RP2354B (RP2350B + 2 MB flash in package): the FROB RAM, control register and both mailboxes in firmware. Core 0 serves the Apple bus (left), core 1 the 2600 bus (right). Pin map = firmware/src/frob_pins.h. GP40-47 (ADC pads) are NOT 5 V tolerant: they only see 3.3 V buffer outputs. BOOTSEL: hold S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

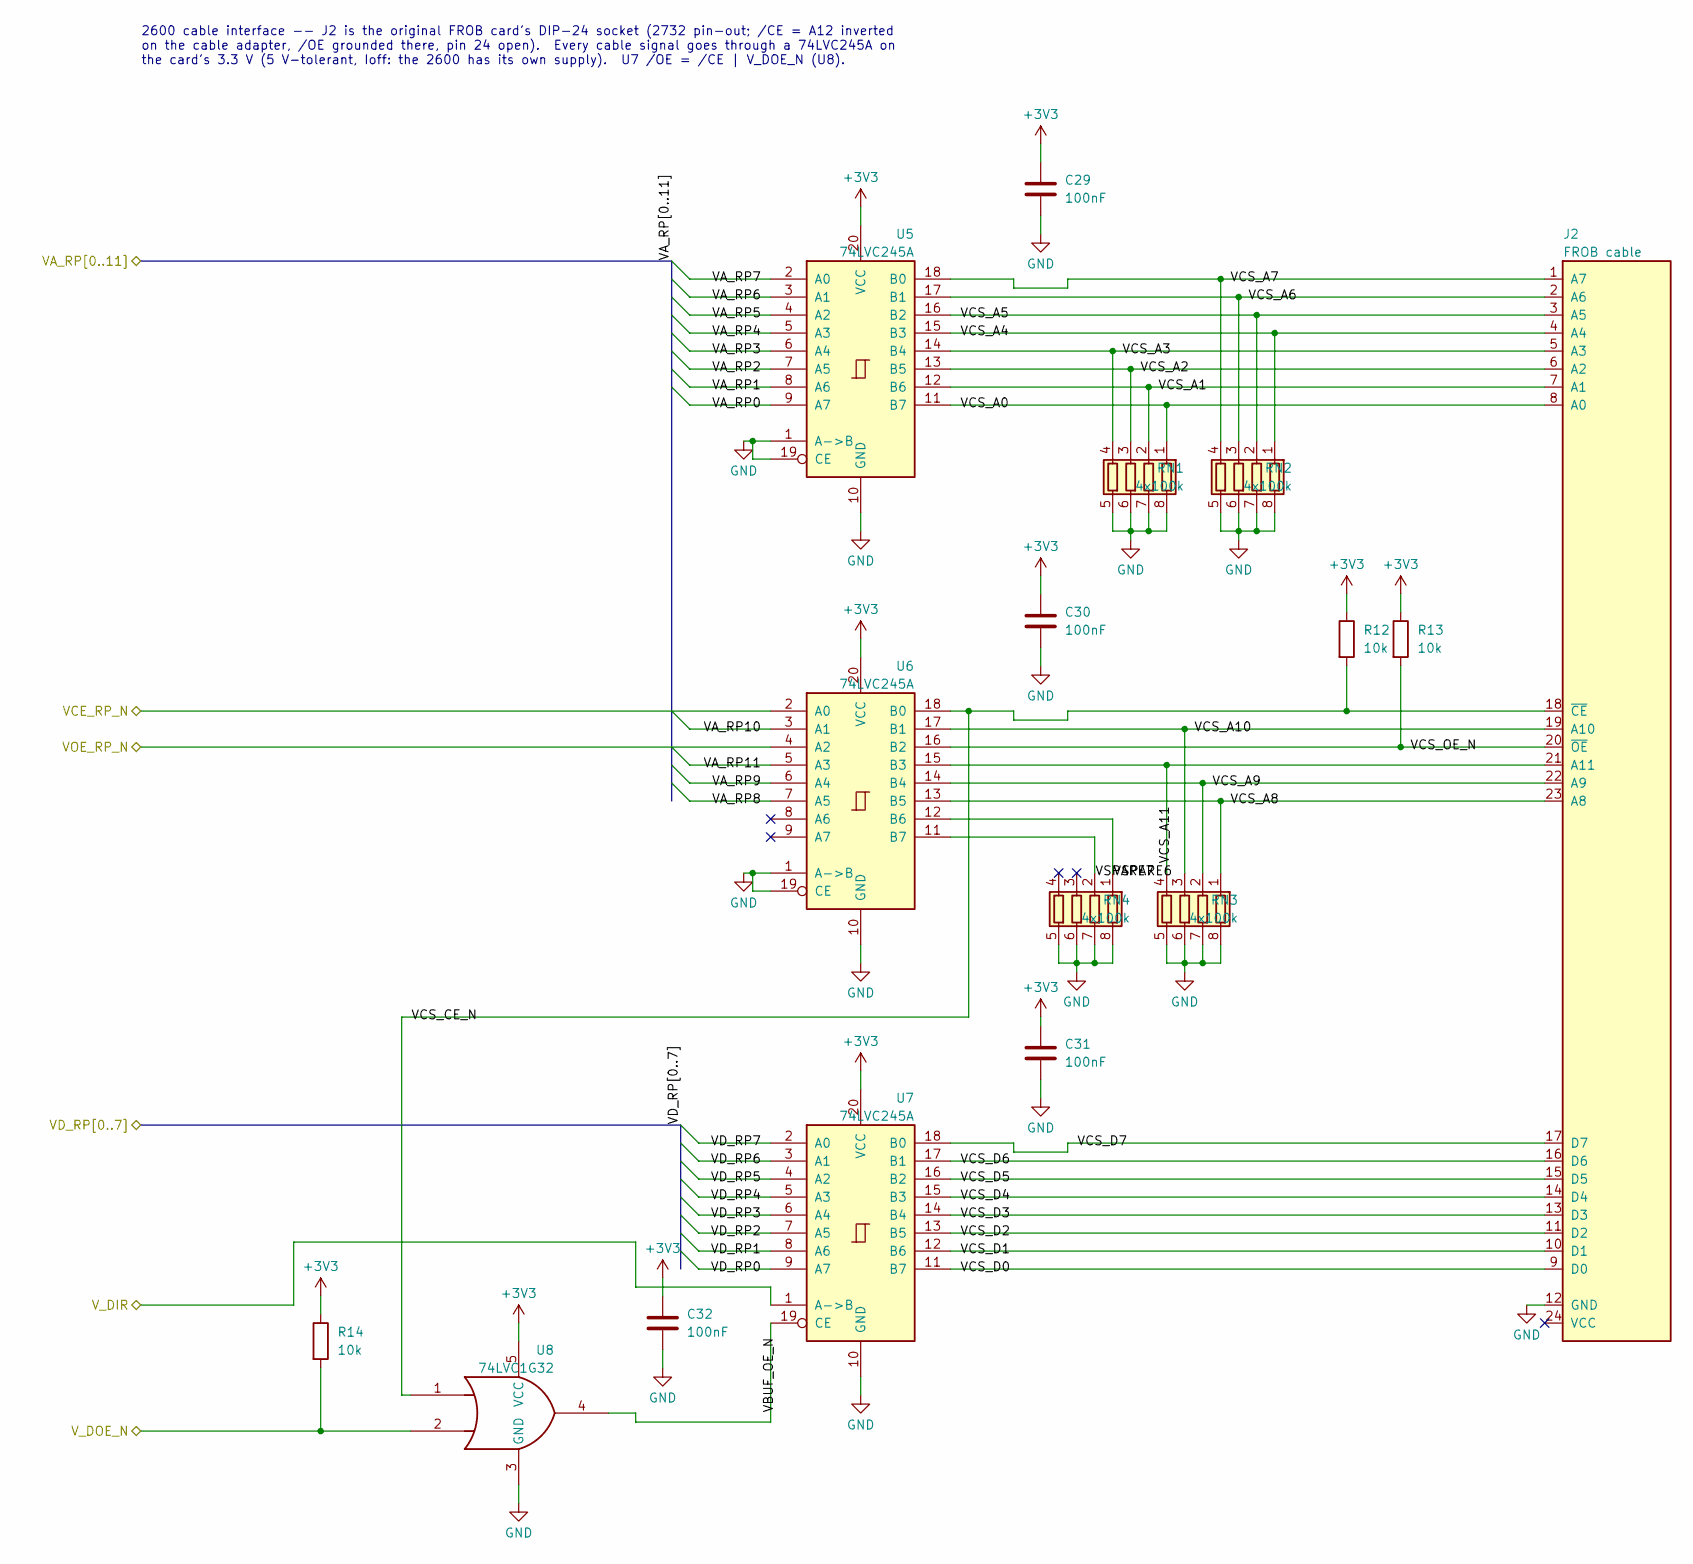
[picture p27: schematic vcs.kicad_sch, Frob2354 - 2600 cable (FROB J2) interface]

Parts:
C29, C30, C31, C32: 100nF; C_0603_1608Metric; MPN CC0603KRX7R9BB104; LCSC C14663
J2: FROB cable; DIP-24_W15.24mm_Socket; MPN 110-43-624-41-001000
R12, R13, R14: 10k; R_0603_1608Metric; MPN 0603WAF1002T5E; LCSC C25804
RN1, RN2, RN3, RN4: 4x100k; R_Array_Convex_4x0603; MPN 4D03WGJ0104T5E; LCSC C1996
U5, U6, U7: 74LVC245A; TSSOP-20_4.4x6.5mm_P0.65mm; MPN SN74LVC245APWR; LCSC C7848
U8: 74LVC1G32; SOT-23-5; MPN SN74LVC1G32DBVR; LCSC C10096

Connections:
+3V3: C29.1, C30.1, C31.1, C32.1, R12.1, R13.1, R14.1, U5.20 (VCC), U6.20 (VCC), U7.20 (VCC), U8.5 (VCC); also elsewhere on the board
/mcu/VA_RP0: U5.9 (A7); also elsewhere on the board
/mcu/VA_RP1: U5.8 (A6); also elsewhere on the board
/mcu/VA_RP2: U5.7 (A5); also elsewhere on the board
/mcu/VA_RP3: U5.6 (A4); also elsewhere on the board
/mcu/VA_RP4: U5.5 (A3); also elsewhere on the board
/mcu/VA_RP5: U5.4 (A2); also elsewhere on the board
/mcu/VA_RP6: U5.3 (A1); also elsewhere on the board
/mcu/VA_RP7: U5.2 (A0); also elsewhere on the board
/mcu/VA_RP8: U6.7 (A5); also elsewhere on the board
/mcu/VA_RP9: U6.6 (A4); also elsewhere on the board
/mcu/VA_RP10: U6.3 (A1); also elsewhere on the board
/mcu/VA_RP11: U6.5 (A3); also elsewhere on the board
/mcu/VCE_RP_N: U6.2 (A0); also elsewhere on the board
/mcu/VD_RP0: U7.9 (A7); also elsewhere on the board
/mcu/VD_RP1: U7.8 (A6); also elsewhere on the board
/mcu/VD_RP2: U7.7 (A5); also elsewhere on the board
/mcu/VD_RP3: U7.6 (A4); also elsewhere on the board
/mcu/VD_RP4: U7.5 (A3); also elsewhere on the board
/mcu/VD_RP5: U7.4 (A2); also elsewhere on the board
/mcu/VD_RP6: U7.3 (A1); also elsewhere on the board
/mcu/VD_RP7: U7.2 (A0); also elsewhere on the board
/mcu/VOE_RP_N: U6.4 (A2); also elsewhere on the board
/mcu/V_DIR: U7.1 (A->B); also elsewhere on the board
/mcu/V_DOE_N: R14.2, U8.2; also elsewhere on the board
/vcs/VBUF_OE_N: U7.19 (CE), U8.4
/vcs/VCS_A0: J2.8 (A0), RN1.1 (R1.1), U5.11 (B7)
/vcs/VCS_A1: J2.7 (A1), RN1.2 (R2.1), U5.12 (B6)
/vcs/VCS_A2: J2.6 (A2), RN1.3 (R3.1), U5.13 (B5)
/vcs/VCS_A3: J2.5 (A3), RN1.4 (R4.1), U5.14 (B4)
/vcs/VCS_A4: J2.4 (A4), RN2.1 (R1.1), U5.15 (B3)
/vcs/VCS_A5: J2.3 (A5), RN2.2 (R2.1), U5.16 (B2)
/vcs/VCS_A6: J2.2 (A6), RN2.3 (R3.1), U5.17 (B1)
/vcs/VCS_A7: J2.1 (A7), RN2.4 (R4.1), U5.18 (B0)
/vcs/VCS_A8: J2.23 (A8), RN3.1 (R1.1), U6.13 (B5)
/vcs/VCS_A9: J2.22 (A9), RN3.2 (R2.1), U6.14 (B4)
/vcs/VCS_A10: J2.19 (A10), RN3.3 (R3.1), U6.17 (B1)
/vcs/VCS_A11: J2.21 (A11), RN3.4 (R4.1), U6.15 (B3)
/vcs/VCS_CE_N: J2.18 (~CE), R12.2, U6.18 (B0), U8.1
/vcs/VCS_D0: J2.9 (D0), U7.11 (B7)
/vcs/VCS_D1: J2.10 (D1), U7.12 (B6)
/vcs/VCS_D2: J2.11 (D2), U7.13 (B5)
/vcs/VCS_D3: J2.13 (D3), U7.14 (B4)
/vcs/VCS_D4: J2.14 (D4), U7.15 (B3)
/vcs/VCS_D5: J2.15 (D5), U7.16 (B2)
/vcs/VCS_D6: J2.16 (D6), U7.17 (B1)
/vcs/VCS_D7: J2.17 (D7), U7.18 (B0)
/vcs/VCS_OE_N: J2.20 (~OE), R13.2, U6.16 (B2)
/vcs/VSPARE6: RN4.1 (R1.1), U6.12 (B6)
/vcs/VSPARE7: RN4.2 (R2.1), U6.11 (B7)
GND: C29.2, C30.2, C31.2, C32.2, J2.12 (GND), RN1.5 (R4.2), RN1.6 (R3.2), RN1.7 (R2.2), RN1.8 (R1.2), RN2.5 (R4.2), RN2.6 (R3.2), RN2.7 (R2.2), RN2.8 (R1.2), RN3.5 (R4.2), RN3.6 (R3.2), RN3.7 (R2.2), RN3.8 (R1.2), RN4.5 (R4.2), RN4.6 (R3.2), RN4.7 (R2.2), RN4.8 (R1.2), U5.1 (A->B), U5.10 (GND), U5.19 (CE), U6.1 (A->B), U6.10 (GND), U6.19 (CE), U7.10 (GND), U8.3 (GND); also elsewhere on the board

Notes on the sheet:
2600 cable interface -- J2 is the original FROB card's DIP-24 socket (2732 pin-out; /CE = A12 inverted on the cable adapter, /OE grounded there, pin 24 open). Every cable signal goes through a 74LVC245A on the card's 3.3 V (5 V-tolerant, Ioff: the 2600 has its own supply). U7 /OE = /CE | V_DOE_N (U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

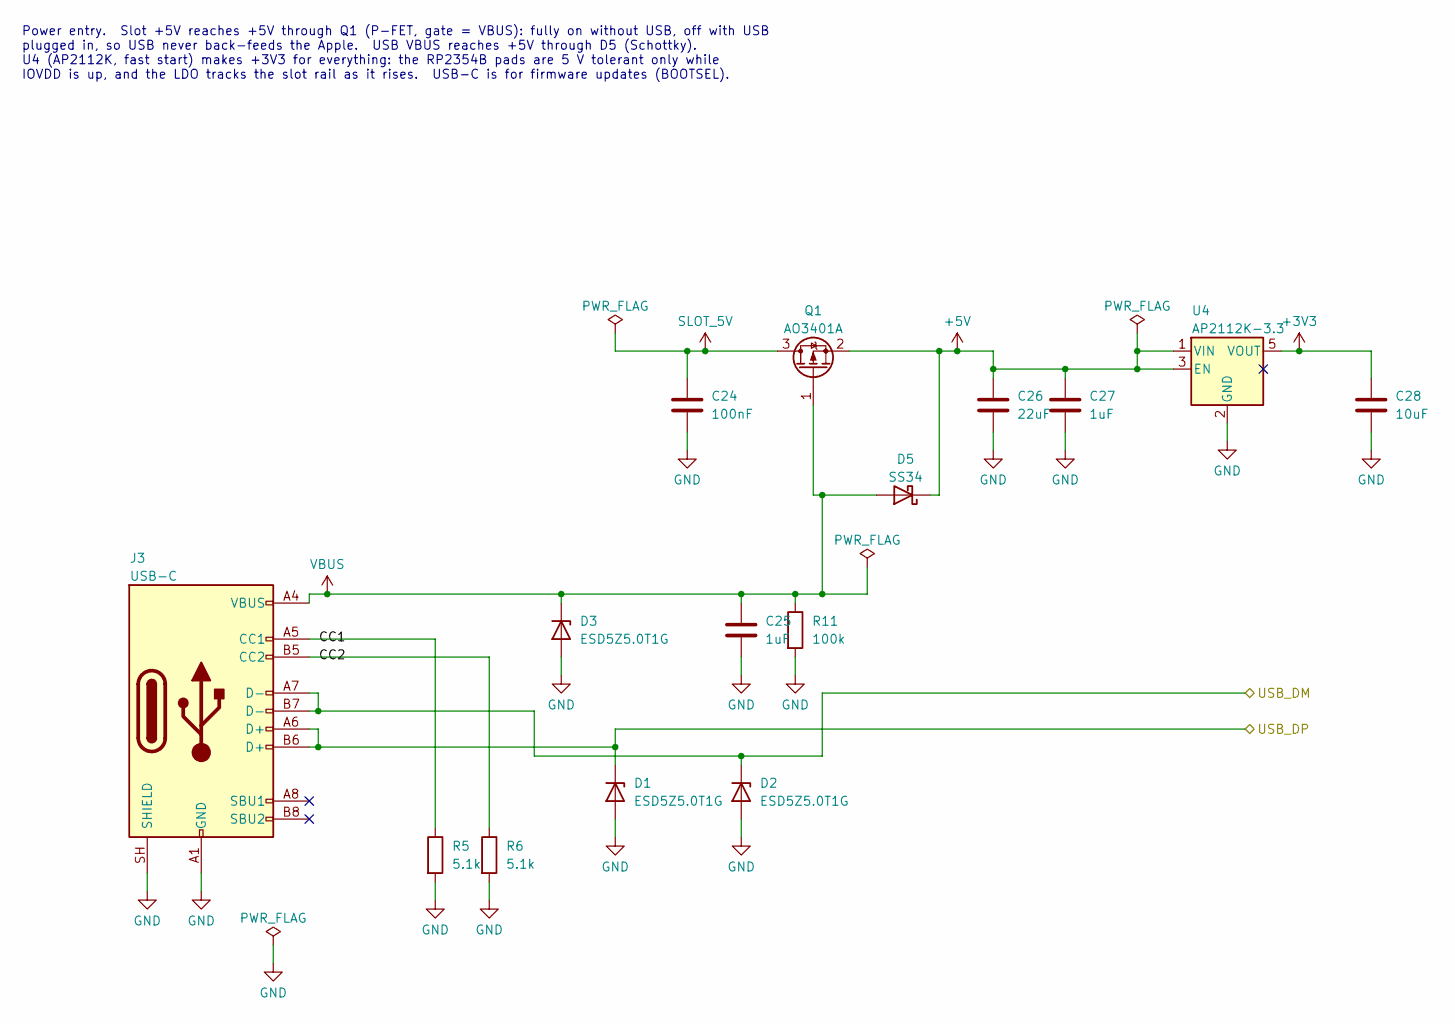
[picture p28: schematic power.kicad_sch, Frob2354 - Power entry, 3.3 V, USB-C]

Parts:
C24: 100nF; C_0603_1608Metric; MPN CC0603KRX7R9BB104; LCSC C14663
C25, C27: 1uF; C_0603_1608Metric; MPN CL10A105KB8NNNC; LCSC C15849
C26: 22uF; C_0805_2012Metric; MPN CL21A226MAQNNNE; LCSC C45783
C28: 10uF; C_0603_1608Metric; MPN CL10A106KP8NNNC; LCSC C19702
D1, D2, D3: ESD5Z5.0T1G; D_SOD-523; MPN ESD5Z5.0T1G; LCSC C82044
D5: SS34; D_SMA; MPN SS34; LCSC C8678
J3: USB-C; USB_C_Receptacle_HRO_TYPE-C-31-M-12; MPN TYPE-C-31-M-12; LCSC C165948
Q1: AO3401A; SOT-23; MPN AO3401A; LCSC C15127
R5, R6: 5.1k; R_0603_1608Metric; MPN 0603WAF5101T5E; LCSC C23186
R11: 100k; R_0603_1608Metric; MPN 0603WAF1003T5E; LCSC C25803
U4: AP2112K-3.3; SOT-23-5; MPN AP2112K-3.3TRG1; LCSC C51118

Connections:
+3V3: C28.1, U4.5 (VOUT); also elsewhere on the board
+5V: C26.1, C27.1, D5.1 (K), Q1.2 (S), U4.1 (VIN), U4.3 (EN)
/mcu/USB_DM: D2.1 (K), J3.A7 (D-), J3.B7 (D-); also elsewhere on the board
/mcu/USB_DP: D1.1 (K), J3.A6 (D+), J3.B6 (D+); also elsewhere on the board
/power/CC1: J3.A5 (CC1), R5.1
/power/CC2: J3.B5 (CC2), R6.1
GND: C24.2, C25.2, C26.2, C27.2, C28.2, D1.2 (A), D2.2 (A), D3.2 (A), J3.A1 (GND), J3.A12 (GND), J3.B1 (GND), J3.B12 (GND), J3.SH (SHIELD), R5.2, R6.2, R11.2, U4.2 (GND); also elsewhere on the board
SLOT_5V: C24.1, Q1.3 (D); also elsewhere on the board
VBUS: C25.1, D3.1 (K), D5.2 (A), J3.A4 (VBUS), J3.A9 (VBUS), J3.B4 (VBUS), J3.B9 (VBUS), Q1.1 (G), R11.1

Notes on the sheet:
Power entry. Slot +5V reaches +5V through Q1 (P-FET, gate = VBUS): fully on without USB, off with USB plugged in, so USB never back-feeds the Apple. USB VBUS reaches +5V through D5 (Schottky). U4 (AP2112K, fast start) makes +3V3 for everything: the RP2354B pads are 5 V tolerant only while IOVDD is 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

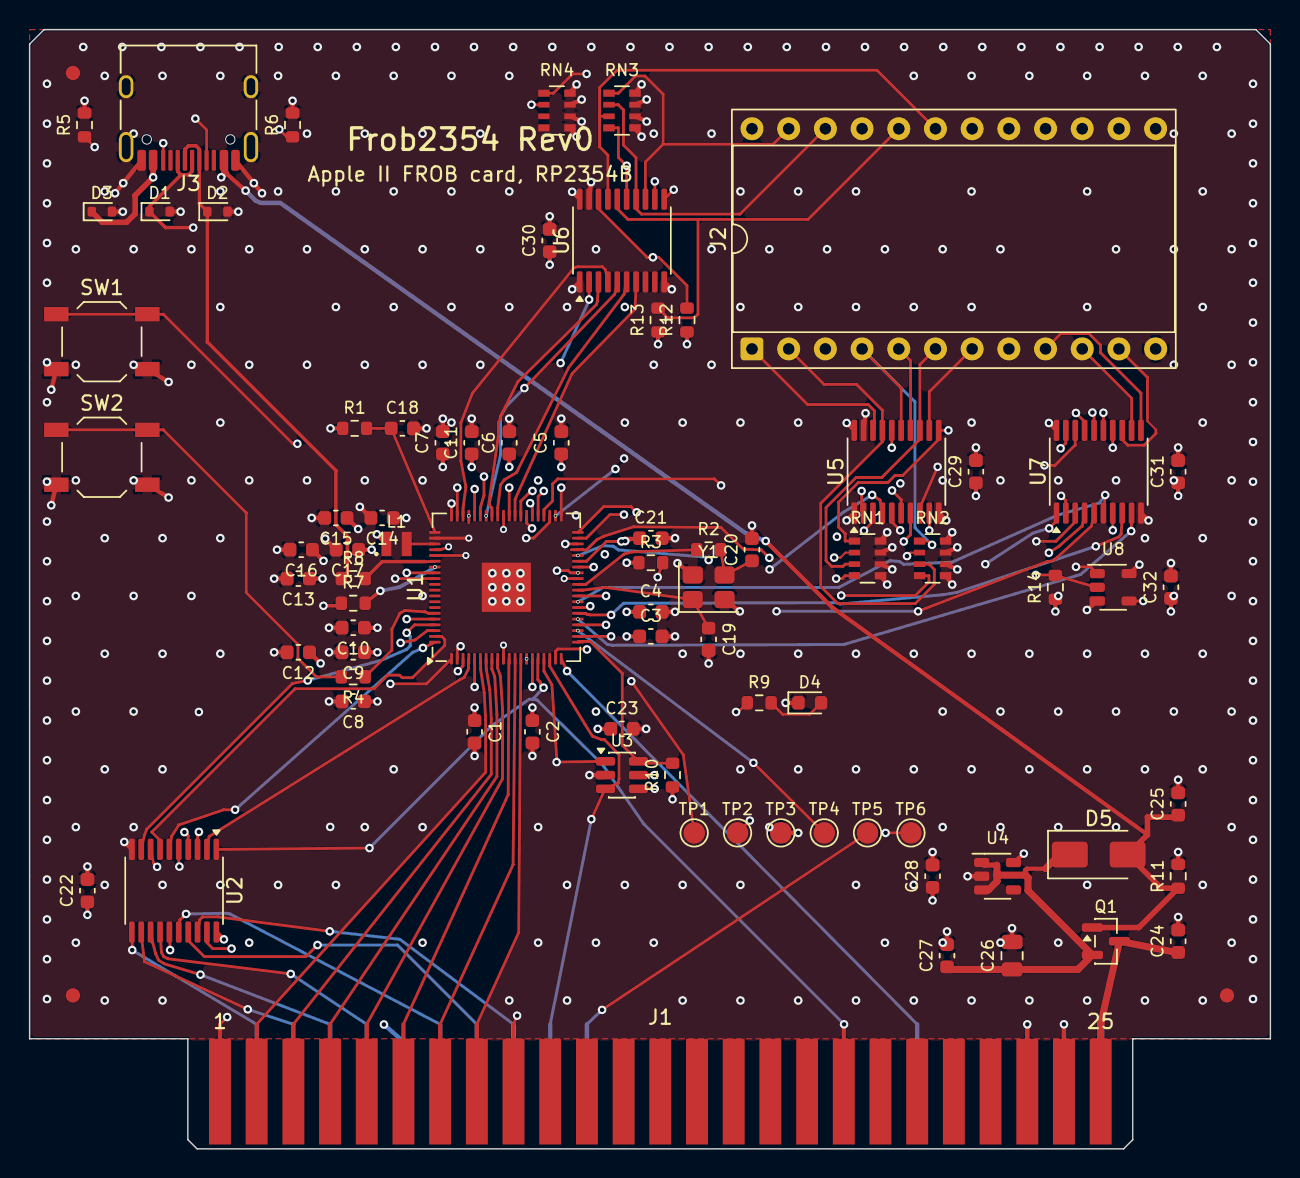
[picture p29: board Frob2354.kicad_pcb from above]

Board: 6 copper layers, 85.9 x 77.5 mm, 80 parts (0 on the bottom side), 107 nets.

Other parts of the board:
FID1, FID2, FID3: Fiducial_1mm_Mask2mm
