tschak909/frob-modern/hardware/tools/gen_pcb.py

#!/usr/bin/env python3
"""Generate Frob2354.kicad_pcb (placed, unrouted) from design.py.

Board: an Apple II peripheral card in the original FROB card's frame (the
reverse-engineered a2board.kicad_pcb): the card edge tab x 127.9525..193.3575,
y 95.25..102.87 (y = 102.87 is the insertion edge), the body above it up to
y = 25.4 (2.75 in tall) and back to x = 202.8825 (the rear, next to the
back panel, exactly as the original).  The front is cut back from the
original 7 in to X0: one RP2354B needs far less room than 24 DIPs.
1.6 mm, 6 copper layers (FujiNet-NES-Rev0's stack-up; on 4 layers -- two
signal layers -- Freerouting plus the finisher left ~16 connections open
around the RP2354B's 0.4 mm pin rows):
  F.Cu signals + GND pour / In1 GND plane / In2 + In3 signals /
  In4 +3V3 plane with a DVDD island under the RP2354B core / B.Cu signals + GND pour.
The 50 fingers (25 per face) are the only copper on the tab; each gets a
short locked stub into the body so the routers never enter the tab.

The footprints are written as S-expressions (the SWIG pcbnew bindings are
not reliable under Python 3.14); route.py does the DSN/SES round trip and
the zone fills through pcbnew.  Structure from FujiNet-NES-Rev0/tools.

Usage: python3 tools/gen_pcb.py
"""
import os, sys, math, uuid, copy, json
sys.path.insert(0, os.path.dirname(os.path.abspath(__file__)))
from sexpr import parse, dump, find, findall, Q
import design as D
import gen_sch

HERE = os.path.dirname(os.path.abspath(__file__))
PRJ = os.path.dirname(HERE)
PCB = os.path.join(PRJ, D.PROJECT + '.kicad_pcb')

# ---- geometry (mm, KiCad frame: y down) -----------------------------------
X0, X1 = 117.0, 202.8825        # front edge (cut back), rear edge (original)
Y0 = 25.4                       # top edge
TAB_Y = 95.25                   # tab base = bottom of the body
Y1 = 102.87                     # insertion edge
TAB_X0, TAB_X1 = 127.9525, 193.3575
XC = (TAB_X0 + TAB_X1) / 2      # 160.655: J1 origin x
PAD_TOP_Y = TAB_Y               # finger copper starts at the tab base
BLADE_Y = TAB_Y                 # routers: no tracks/vias at y >= BLADE_Y
THICKNESS = 1.6
CH = 0.635                      # tab corner chamfers (original: 0.635 at the insertion edge)
OUTLINE = [(X0 + 1.0, Y0), (X1 - 1.0, Y0), (X1, Y0 + 1.0), (X1, TAB_Y),
           (TAB_X1, TAB_Y), (TAB_X1, Y1 - CH), (TAB_X1 - CH, Y1), (TAB_X0 + CH, Y1), (TAB_X0, Y1 - CH),
           (TAB_X0, TAB_Y), (X0, TAB_Y), (X0, Y0 + 1.0)]
HOLES = []
KEEP_CLEAR = []
BODY = [(X0, Y0), (X1, Y0), (X1, TAB_Y), (X0, TAB_Y)]   # planes / pours (clipped by the outline)

RP_CORE = 3.6       # west edge of the DVDD island under the RP2354B core (the VREG_VIN via sits beyond it)
DVDD_R = 4.3        # its north/east/south extent: past the DVDD pins' inward vias (4.0 + 0.25 barrel)
UNDER = 4.6         # half-size of the square under the RP the finisher keeps off F.Cu (and via-free)

# ref -> (x, y, rotation deg CCW)  -- top view, y down
PLACE = {}


def place(ref, x, y, rot=0):
    PLACE[ref] = (round(x, 3), round(y, 3), rot)


def uid(*k):
    return gen_sch.uid('pcb', *k)


# ---------------------------------------------------------------------------
def rot_pt(x, y, a):
    r = math.radians(a)
    # KiCad: positive angle = CCW on screen (y down) -> x' = x cos + y sin, y' = -x sin + y cos
    return x * math.cos(r) + y * math.sin(r), -x * math.sin(r) + y * math.cos(r)


def load_fp(name):
    return parse(open(os.path.join(PRJ, D.LIB + '.pretty', name + '.kicad_mod')).read())


def schematic_netlist():
    """(ref, pad) -> net name, from the generated schematic (kicad-cli), so the
    board carries exactly the schematic's nets -- including KiCad's own
    unconnected-(...) names for no-connect pins."""
    import subprocess, tempfile
    fn = os.path.join(tempfile.gettempdir(), 'fujinet-nes-gen.net')
    subprocess.run(['kicad-cli', 'sch', 'export', 'netlist', '--format', 'kicadsexpr', '-o', fn,
                    os.path.join(PRJ, D.PROJECT + '.kicad_sch')], check=True, capture_output=True)
    t = parse(open(fn).read())
    out = {}
    for n in findall(find(t, 'nets'), 'net'):
        name = str(find(n, 'name')[1])
        for nd in findall(n, 'node'):
            out[(str(find(nd, 'ref')[1]), str(find(nd, 'pin')[1]))] = name
    return out


NETLIST = {}
import re as _re
SMALL = _re.compile(r'_0603_|_0805_|SOD-523|SOT-23|R_Array|L_2016|Crystal_SMD|TestPoint|RPI_L')


def instance(part, x, y, rot, path, sheetname, sheetfile, datasheet=''):
    fp = load_fp(part.footprint.split(':')[1])
    for i, e in enumerate(fp):   # legacy (fp_text reference/value ...) -> (property ...)
        if isinstance(e, list) and e and e[0] == 'fp_text' and e[1] in ('reference', 'value'):
            fp[i] = ['property', Q('Reference' if e[1] == 'reference' else 'Value'), e[2]] + e[3:]
    out = ['footprint', Q(part.footprint), ['layer', Q('F.Cu')], ['uuid', uid(part.ref)],
           ['at', x, y, rot] if rot else ['at', x, y]]
    for k in ('descr', 'tags'):
        e = find(fp, k)
        if e:
            out.append(e)
    fields = {'Reference': part.ref, 'Value': part.value, 'Footprint': part.footprint,
              'Datasheet': datasheet, 'Description': part.desc, 'MPN': part.mpn, 'LCSC': part.lcsc}
    done = set()
    for pr in findall(fp, 'property'):
        k = pr[1]
        if k in fields:
            pr = copy.deepcopy(pr)
            pr[2] = Q(fields[k])
            at = find(pr, 'at')
            ang = (float(at[3]) if len(at) > 3 else 0) + rot
            at[:] = ['at', float(at[1]), float(at[2]), ang % 360]
            pr = [e for e in pr if not (isinstance(e, list) and e and e[0] == 'uuid')]
            pr.insert(3, ['uuid', uid(part.ref, 'prop', k)])
            if k == 'Reference' and SMALL.search(part.footprint):
                pr = [e for e in pr if not (isinstance(e, list) and e and e[0] == 'effects')]
                pr.append(['effects', ['font', ['size', 0.8, 0.8], ['thickness', 0.12]]])
            out.append(pr); done.add(k)
    for k, v in fields.items():
        if k not in done:
            out.append(['property', Q(k), Q(v), ['at', 0, 0, rot], ['layer', Q('F.Fab')], ['hide', 'yes'],
                        ['uuid', uid(part.ref, 'prop', k)],
                        ['effects', ['font', ['size', 1.27, 1.27], ['thickness', 0.15]]]])
    out += [['path', Q(path)], ['sheetname', Q(sheetname)], ['sheetfile', Q(sheetfile)]]
    attr = find(fp, 'attr')
    a = list(attr) if attr else ['attr', 'smd']
    if not part.bom and 'exclude_from_bom' not in a:
        a.append('exclude_from_bom')
    if getattr(part, 'dnp', False) and 'dnp' not in a:
        a.append('dnp')
    out.append(a)
    for e in fp[2:]:
        if not isinstance(e, list) or not e:
            continue
        if e[0] in ('version', 'generator', 'generator_version', 'layer', 'descr', 'tags', 'property',
                    'attr', 'uuid', 'embedded_fonts'):
            continue
        if e[0] == 'fp_text':
            e = copy.deepcopy(e)
            at = find(e, 'at')
            ang = (float(at[3]) if len(at) > 3 else 0) + rot
            at[:] = ['at', float(at[1]), float(at[2]), ang % 360]
            if e[2] == '%R':
                e[2] = Q('${REFERENCE}')
            out.append(e)
        elif e[0] == 'pad':
            e = copy.deepcopy(e)
            at = find(e, 'at')
            ang = (float(at[3]) if len(at) > 3 else 0) + rot
            at[:] = ['at', float(at[1]), float(at[2])] + ([ang % 360] if ang % 360 else [])
            e = [x_ for x_ in e if not (isinstance(x_, list) and x_ and x_[0] in ('net', 'uuid'))]
            num = str(e[1])
            net = part.pins.get(num)
            if num and num not in part.pins and e[2] != 'np_thru_hole':
                raise SystemExit('%s pad %s has no pin in design.py' % (part.ref, num))
            if num and part.pins:
                sn = NETLIST.get((part.ref, num))
                # the hierarchical schematic names local nets by sheet path (/mcu/XIN for XIN)
                if net and (sn or '').rsplit('/', 1)[-1] != net:
                    raise SystemExit('%s pad %s: design %s vs schematic %s' % (part.ref, num, net, sn))
                net = sn
            if net:
                e.append(['net', Q(net)])
            e.append(['uuid', uid(part.ref, 'pad', num, len(out))])
            out.append(e)
        elif e[0] == 'zone':  # footprint zones are stored in board coordinates
            e = copy.deepcopy(e)
            for pts in findall(find(e, 'polygon'), 'pts'):
                for xy in pts[1:]:
                    dx, dy = rot_pt(float(xy[1]), float(xy[2]), rot)
                    xy[1], xy[2] = round(x + dx, 4), round(y + dy, 4)
            out.append(e)
        else:
            out.append(copy.deepcopy(e))
    out.append(['embedded_fonts', 'no'])
    return out


def board_pads(board):
    """fanout.Pad list (absolute coordinates) + courtyard boxes by ref."""
    import fanout
    pads, crt = [], {}
    for fp in board:
        if not (isinstance(fp, list) and fp and fp[0] == 'footprint'):
            continue
        at = find(fp, 'at')
        fx, fy = float(at[1]), float(at[2])
        rot = float(at[3]) if len(at) > 3 else 0.0
        ref = [str(e[2]) for e in findall(fp, 'property') if e[1] == 'Reference'][0]
        xs, ys = [], []
        for g in fp:
            if isinstance(g, list) and g and g[0] in ('fp_rect', 'fp_line') and find(g, 'layer')[1] == 'F.CrtYd':
                for k in ('start', 'end'):
                    q = find(g, k)
                    dx, dy = rot_pt(float(q[1]), float(q[2]), rot)
                    xs.append(fx + dx); ys.append(fy + dy)
        if xs:
            crt[ref] = (min(xs), min(ys), max(xs), max(ys))
        for e in findall(fp, 'pad'):
            pat = find(e, 'at'); sz = find(e, 'size')
            dx, dy = rot_pt(float(pat[1]), float(pat[2]), rot)
            pang = (float(pat[3]) if len(pat) > 3 else 0.0) % 180
            w, h = float(sz[1]), float(sz[2])
            if abs(pang - 90) < 1:
                w, h = h, w
            elif pang not in (0.0,):
                w = h = max(w, h)
            net = find(e, 'net')
            layers = [str(x_) for x_ in find(e, 'layers')[1:]]
            th = e[2] in ('thru_hole', 'np_thru_hole')
            if th:
                layers = ['F.Cu', 'B.Cu']
            pads.append(fanout.Pad(ref, str(e[1]), str(net[1]) if net else None, fx + dx, fy + dy,
                                   w / 2, h / 2, layers, th, (fx, fy)))
    return pads, crt


# ---------------------------------------------------------------------------
def seg(x0, y0, x1, y1, w, layer, net, key, locked=True):
    s = ['segment', ['start', round(x0, 4), round(y0, 4)], ['end', round(x1, 4), round(y1, 4)],
         ['width', w], ['layer', Q(layer)]]
    if locked:
        s.append(['locked', 'yes'])
    return s + [['net', Q(net)], ['uuid', uid(*key)]]


def via(x, y, net, key, size=0.6, drill=0.3):
    return ['via', ['at', round(x, 4), round(y, 4)], ['size', size], ['drill', drill],
            ['layers', Q('F.Cu'), Q('B.Cu')], ['locked', 'yes'], ['net', Q(net)], ['uuid', uid(*key)]]


def finger_stubs(board):
    """Each finger gets a locked stub on its own face from 0.2 mm inside its
    inner end up into the body (y = TAB_Y - 1.0), so the routers only ever
    touch the stub end (0.5 mm for the supply fingers, 0.3 mm for signals).
    The tab itself is a track/via keepout."""
    out = []
    j1 = [e for e in board if isinstance(e, list) and e and e[0] == 'footprint'
          and any(p[1] == 'Reference' and p[2] == 'J1' for p in findall(e, 'property'))][0]
    fx = float(find(j1, 'at')[1])      # J1 sits at rotation 0: pad x is footprint x + local x
    for pd in findall(j1, 'pad'):
        a = find(pd, 'at'); net = find(pd, 'net')
        if not net:
            continue
        layer = str(find(pd, 'layers')[1])
        x = round(fx + float(a[1]), 4)
        n_ = str(net[1])
        if n_.startswith('unconnected'):
            continue
        w = 0.5 if n_ in ('SLOT_5V', 'GND') else 0.3
        out.append(seg(x, PAD_TOP_Y + 0.2, x, TAB_Y - 1.0, w, layer, n_, ('fstub', str(pd[1]))))
    return out


def rp_support(board, ux, uy):
    """Locked copper the RP2354B needs regardless of routing:
      * each DVDD pin (10, 32, 51, 65 = VREG_FB) gets a stub inward to a via
        under the package; those vias meet on a DVDD island in the In4 plane,
        which also reaches west under the core inductor and its capacitor
      * VREG_VIN (64, +3V3) and VREG_PGND (62) get their own short stubs and vias
      * the exposed pad's GND via grid is left to fanout.py (EP_ARRAYS)"""
    out = []
    u1 = [e for e in board if isinstance(e, list) and e and e[0] == 'footprint'
          and any(p[1] == 'Reference' and p[2] == 'U1' for p in findall(e, 'property'))][0]
    at = find(u1, 'at'); rot = float(at[3]) if len(at) > 3 else 0.0
    for pd in findall(u1, 'pad'):
        n = find(pd, 'net')
        if not n or pd[2] != 'smd':
            continue
        net, num, nm = str(n[1]), str(pd[1]), ''
        a = find(pd, 'at')
        px, py = float(a[1]), float(a[2])
        dx, dy = rot_pt(px, py, rot)
        if net == 'DVDD':
            r_in = 4.0     # via radius from the centre: just inside the pad ring (4.55), clear of the EP's
            # fan-out stubs (which cut diagonally toward the exposed pad) and of the EP itself (1.7)
            if abs(dx) > abs(dy):
                vx, vy = math.copysign(r_in, dx), dy
            else:
                vx, vy = dx, math.copysign(r_in, dy)
            if num == '65':       # VREG_FB: further in, so its VREG_VIN neighbour's via fits beside it
                vx, vy = math.copysign(2.8, dx), dy
            pts = [(dx, dy), (vx, vy)]
        elif net == '+3V3' and num == '64':
            # VREG_VIN sits between LX (63) and FB (65), both of which leave along their own
            # axis: it reaches the island through a dog-leg stub and a via under the package
            vx, vy = math.copysign(4.0, dx), dy + math.copysign(0.2, dy)
            pts = [(dx, dy), (math.copysign(4.55, dx), dy), (vx, vy)]
        elif net == 'GND' and num == '62':
            # VREG_PGND: straight in to its own via on the GND plane (its exposed-pad stub
            # would cut through the VREG_VIN via)
            vx, vy = math.copysign(2.6, dx), dy
            pts = [(dx, dy), (vx, vy)]
        else:
            continue
        for i in range(len(pts) - 1):
            (x0_, y0_), (x1_, y1_) = pts[i], pts[i + 1]
            out.append(seg(ux + x0_, uy + y0_, ux + x1_, uy + y1_, 0.2, 'F.Cu', net, ('rpdv', num, i)))
        out.append(via(ux + vx, uy + vy, net, ('rpdvv', num), 0.5, 0.25))
    out.append(zone('rp_dvdd_island', 'DVDD', 'In4.Cu', [(ux + x, uy + y) for x, y in dvdd_island()], priority=5))
    return out


def dvdd_island():
    """The DVDD island on In4, relative to the RP2354B centre (y down): the core under the
    package out to DVDD_R, which covers the DVDD pins' inward vias (rp_support: centre
    4.0, 0.5 mm barrel), the strip under the north pin row, and a lobe west under L1 /
    the DVDD capacitors (placement.py keeps them there).  The notch west of the core
    (x -5.0..-3.6, y > -4.6) stays +3V3 for the VREG_VIN via at (-4.0, -2.8)."""
    return [(-16.0, -5.6), (DVDD_R, -5.6), (DVDD_R, DVDD_R), (-RP_CORE, DVDD_R),
            (-RP_CORE, -4.6), (-5.0, -4.6), (-5.0, -1.6), (-16.0, -1.6)]


def in4_net_at(x, y, ux, uy):
    """Which net the In4 plane carries at (x, y)."""
    if point_in_poly(x - ux, y - uy, dvdd_island()):
        return 'DVDD'
    return '+3V3'


def point_in_poly(x, y, poly):
    inside = False
    n = len(poly)
    for i in range(n):
        (xa, ya), (xb, yb) = poly[i], poly[(i + 1) % n]
        if (ya > y) != (yb > y) and x < xa + (y - ya) * (xb - xa) / (yb - ya):
            inside = not inside
    return inside


def add_fanout(board, extra):
    import fanout
    pads, crt = board_pads(board)
    ux, uy, _ = PLACE['U1']
    extra_segs, extra_vias, served = [], [], set()
    for e in extra:
        net = str(find(e, 'net')[1])
        if e[0] == 'segment':
            s_, t_ = find(e, 'start'), find(e, 'end')
            sg = (float(s_[1]), float(s_[2]), float(t_[1]), float(t_[2]), net, float(find(e, 'width')[1]))
            extra_segs.append(sg)
            for p in pads:
                if p.net == net and (p.dist(sg[0], sg[1]) < 1e-6 or p.dist(sg[2], sg[3]) < 1e-6):
                    served.add(id(p))
        elif e[0] == 'via':
            a = find(e, 'at')
            extra_vias.append((float(a[1]), float(a[2]), net))
    # a pad only gets a plane via where the In4 plane carries its net (GND is In1, everywhere);
    # judged where the via will sit: a fine-pitch pin's via goes straight out along its
    # axis (fanout.plan), past the DVDD strip under the RP's pin rows
    def via_spot(p):
        if min(p.hw, p.hh) <= 0.15:
            fx, fy = p.fp_xy
            if p.hh > p.hw:
                return p.cx, p.cy + math.copysign(2.0, p.cy - fy)
            return p.cx + math.copysign(2.0, p.cx - fx), p.cy
        return p.cx, p.cy
    skip = set(served)
    for p in pads:
        if p.net in ('+3V3', 'DVDD') and in4_net_at(*via_spot(p), ux, uy) != p.net:
            skip.add(id(p))
    keep = [crt[r] for r in ('J2', 'J3', 'SW1', 'SW2') if r in crt]
    keep.append((ux - UNDER, uy - UNDER, ux + UNDER, uy + UNDER))   # no fan-out vias under the RP2354B
    holes = [(x, y, d / 2 + 0.5) for x, y, d in HOLES]
    vias, segs, failed = fanout.plan(pads, keep, (X0, Y0, X1, TAB_Y), BLADE_Y, holes, skip_refs=('J1',),
                                     extra_segs=extra_segs, extra_vias=extra_vias, skip_pads=skip)
    for i, (x, y, n) in enumerate(vias):
        board.append(via(x, y, n, ('fv', i), fanout.VIA_D, fanout.VIA_DRILL))
    for i, (x0, y0, x1, y1, n, w) in enumerate(segs):
        board.append(seg(x0, y0, x1, y1, round(w, 3), 'F.Cu', n, ('fs', i)))
    print('fan-out: %d vias, %d stubs%s' % (len(vias), len(segs),
          ('; FAILED: ' + ' '.join(failed)) if failed else ''))


def outline():
    g = []
    n = len(OUTLINE)
    for i in range(n):
        a, b = OUTLINE[i], OUTLINE[(i + 1) % n]
        g.append(['gr_line', ['start', *a], ['end', *b], ['stroke', ['width', 0.1], ['type', 'default']],
                  ['layer', Q('Edge.Cuts')], ['uuid', uid('edge', i)]])
    for i, (x, y, d) in enumerate(HOLES):
        g.append(['gr_circle', ['center', x, y], ['end', x + d / 2, y], ['stroke', ['width', 0.1], ['type', 'default']],
                  ['fill', 'no'], ['layer', Q('Edge.Cuts')], ['uuid', uid('hole', i)]])
    return g


def zone(name, net, layer, pts, keepout=False, priority=0, no_parts=False):
    z = ['zone', ['net', Q(net)] if net else ['net', Q('')], ['layer', Q(layer)], ['uuid', uid('zone', name, layer)],
         ['name', Q(name)], ['hatch', 'edge', 0.5]]
    if priority:
        z.append(['priority', priority])
    z += [['connect_pads', ['clearance', 0 if keepout else 0.25]], ['min_thickness', 0.25]]
    if keepout:
        z.append(['keepout', ['tracks', 'allowed' if no_parts else 'not_allowed'], ['vias', 'allowed' if no_parts else 'not_allowed'],
                  ['pads', 'allowed'], ['copperpour', 'allowed' if no_parts else 'not_allowed'],
                  ['footprints', 'not_allowed' if no_parts else 'allowed']])
        z.append(['placement', ['enabled', 'no'], ['sheetname', Q('')]])
    z.append(['fill', 'yes', ['thermal_gap', 0.3], ['thermal_bridge_width', 0.4], ['island_removal_mode', 0]]
             if not keepout else
             ['fill', ['thermal_gap', 0.5], ['thermal_bridge_width', 0.5], ['island_removal_mode', 0]])
    z.append(['polygon', ['pts'] + [['xy', round(x, 4), round(y, 4)] for x, y in pts]])
    return z


def circle_pts(x, y, r, n=12):
    return [(x + r * math.cos(2 * math.pi * i / n), y + r * math.sin(2 * math.pi * i / n)) for i in range(n)]


def text(s, x, y, layer, size=1.0, mirror=False, rot=0):
    eff = ['effects', ['font', ['size', size, size], ['thickness', size * 0.15]]]
    if mirror:
        eff.append(['justify', 'mirror'])
    return ['gr_text', Q(s), ['at', x, y, rot], ['layer', Q(layer)], ['uuid', uid('text', s)], eff]


# ---------------------------------------------------------------------------
from placement import do_placement  # noqa: E402  (placement table lives in its own file)


NETCLASSES = [  # name, clearance, track, via dia, via drill, nets
    ('PWR', 0.15, 0.5, 0.8, 0.4, ['+5V', 'SLOT_5V', '+3V3']),     # 0.15: what the routers used (pcbnew's save drops the patterns mid-flow)
    ('VBUS', 0.15, 0.4, 0.6, 0.3, ['VBUS']),
    ('USB', 0.15, 0.25, 0.6, 0.3, ['*USB_DP', '*USB_DM']),        # patterns: names carry a sheet path
]


def configure_project():
    """Design rules + net classes in the .kicad_pro (JLCPCB 6-layer capable)."""
    fn = os.path.join(PRJ, D.PROJECT + '.kicad_pro')
    pro = json.load(open(fn))
    r = pro['board']['design_settings']['rules']
    # JLCPCB multilayer: trace/space 0.09, via 0.25/0.15, annular 0.125, copper-edge 0.2; the
    # rules sit above every one of those.  No mask-bridge check: JLC opens the mask as one
    # window across 0.4 mm-pitch pins (QFN-80, QFN-28, TSOP 0.5 mm) rather than dam them.
    # vias: 0.6/0.3 everywhere (net classes) except via_in_pad.py's 0.25/0.15 in the RP2354B's pads
    # (JLCPCB 6-layer minimum, filled and capped); see the via_in_pad rule in the .kicad_dru
    r.update({'min_clearance': 0.12, 'min_copper_edge_clearance': 0.25, 'min_track_width': 0.1,
              'min_via_diameter': 0.25, 'min_through_hole_diameter': 0.15, 'min_hole_clearance': 0.2,
              'min_hole_to_hole': 0.25, 'min_via_annular_width': 0.05, 'solder_mask_min_width': 0.0,
              'solder_mask_clearance': 0.0, 'solder_mask_to_copper_clearance': 0.0})
    # the 50 fingers share one mask window per face: KiCad reports that as a mask bridge
    # between nets; it is the intended gold-finger process
    pro['board']['design_settings'].setdefault('rule_severities', {})['solder_mask_bridge'] = 'warning'
    ns = pro['net_settings']
    base = dict(ns['classes'][0])
    base.update({'name': 'Default', 'clearance': 0.15, 'track_width': 0.2, 'via_diameter': 0.6, 'via_drill': 0.3})
    classes = [base]
    patterns = []
    for i, (name, cl, tw, vd, vdr, nets) in enumerate(NETCLASSES):
        c = dict(base)
        c.update({'name': name, 'clearance': cl, 'track_width': tw, 'via_diameter': vd, 'via_drill': vdr,
                  'priority': i})
        classes.append(c)
        patterns += [{'netclass': name, 'pattern': n} for n in nets]
    ns['classes'] = classes
    ns['netclass_patterns'] = patterns
    ns['netclass_assignments'] = None
    root = str(gen_sch.uid('root'))
    pro['sheets'] = [[root, 'Root']] + [[str(gen_sch.uid('sheet', st)), st] for st, _, _ in D.SHEETS]
    pro['pcbnew'] = pro.get('pcbnew', {})
    pro['pcbnew'].setdefault('last_paths', {})['specctra_dsn'] = ''
    json.dump(pro, open(fn, 'w'), indent=2)
    open(fn, 'a').write('\n')
    open(os.path.join(PRJ, D.PROJECT + '.kicad_dru'), 'w').write(
        '(version 1)\n'
        # the RP2354B core-regulator copper (0.4 mm pitch pins, 0402-class room) may use the fab minimum
        '(rule "rp2350_core_corner"\n'
        '\t(condition "A.NetName == \'DVDD\' || A.NetName == \'*RP_LX\' || A.NetName == \'*VREG_AVDD\'")\n'
        '\t(constraint clearance (min 0.12mm)))\n'
        '(rule "default_clearance"\n'
        '\t(condition "A.NetName != \'DVDD\' && A.NetName != \'*RP_LX\' && A.NetName != \'*VREG_AVDD\' && '
        'B.NetName != \'DVDD\' && B.NetName != \'*RP_LX\' && B.NetName != \'*VREG_AVDD\'")\n'
        '\t(constraint clearance (min 0.15mm)))\n'
        # the RP2354B exposed pad and the LDO ground join the pours solidly
        '(rule "gnd_solid_under_ics"\n'
        '\t(condition "A.NetName == \'GND\' && (A.memberOfFootprint(\'U1\') || A.memberOfFootprint(\'U4\'))")\n'
        '\t(constraint zone_connection solid))\n'
        # via-in-pad (via_in_pad.py): only inside the RP2354B's own pads
        '(rule "via_in_pad"\n'
        '\t(condition "A.Type == \'Via\' && A.Hole_Size < 0.2mm")\n'
        '\t(constraint annular_width (min 0.05mm))\n'
        '\t(constraint hole_clearance (min 0.2mm)))\n'
        '(rule "normal_vias"\n'
        '\t(condition "A.Type == \'Via\' && A.Hole_Size >= 0.2mm")\n'
        '\t(constraint annular_width (min 0.125mm))\n'
        '\t(constraint hole_clearance (min 0.25mm)))\n'
        # the fingers run to 0.3 mm from the bevelled insertion edge: gold-finger geometry
        '(rule "finger_edge"\n'
        '\t(condition "A.memberOfFootprint(\'J1\')")\n'
        '\t(constraint edge_clearance (min 0.2mm)))\n')


FIDUCIALS = [('FID1', X0 + 3.0, Y0 + 3.0), ('FID2', X1 - 3.0, TAB_Y - 3.0), ('FID3', X0 + 3.0, TAB_Y - 3.0)]   # three corners of the body


def fiducials():
    """Assembly fiducials (board-only footprints: not in the schematic, BOM or CPL)."""
    out = []
    for ref, x, y in FIDUCIALS:
        fp = load_fp('Fiducial_1mm_Mask2mm')
        inst = ['footprint', Q(D.LIB + ':Fiducial_1mm_Mask2mm'), ['layer', Q('F.Cu')], ['uuid', uid(ref)], ['at', x, y]]
        for e in fp[2:]:
            if not isinstance(e, list) or not e or e[0] in ('version', 'generator', 'generator_version', 'layer'):
                continue
            if e[0] == 'property':
                e = copy.deepcopy(e)
                if e[1] == 'Reference':
                    e[2] = Q(ref)
                e.insert(3, ['uuid', uid(ref, 'prop', e[1])])
            elif e[0] == 'pad':
                e = copy.deepcopy(e)
                e.append(['uuid', uid(ref, 'pad', e[1])])
            out_e = e
            inst.append(out_e)
        out.append(inst)
    return out


def main():
    configure_project()
    do_placement(place)
    NETLIST.update(schematic_netlist())
    hdr = parse(open(os.path.join(HERE, 'pcb_header.sexpr')).read())
    find(find(hdr, 'general'), 'thickness')[1] = THICKNESS
    setup = find(hdr, 'setup')
    setup.insert(2, ['solder_mask_min_width', 0])
    layers = find(hdr, 'layers')
    rest = [l for l in layers[1:] if not str(l[1]).endswith('.Cu')]
    kinds = {'F.Cu': 'signal', 'In1.Cu': 'power', 'In2.Cu': 'signal', 'In3.Cu': 'signal', 'In4.Cu': 'power',
             'B.Cu': 'signal'}
    ids = {'F.Cu': '0', 'B.Cu': '2', 'In1.Cu': '4', 'In2.Cu': '6', 'In3.Cu': '8', 'In4.Cu': '10'}
    layers[1:] = [[ids[n], Q(n), kinds[n]] for n in ('F.Cu', 'In1.Cu', 'In2.Cu', 'In3.Cu', 'In4.Cu', 'B.Cu')] + rest
    board = hdr
    missing = [p.ref for p in D.PARTS if p.ref not in PLACE]
    if missing:
        raise SystemExit('unplaced: ' + ' '.join(missing))
    syms = gen_sch.load_symbols()
    for p in D.PARTS:
        x, y, r = PLACE[p.ref]
        u = gen_sch.units_of(syms[p.lib_id])[0]
        path = '/%s/%s' % (gen_sch.uid('sheet', p.sheet), gen_sch.uid(p.sheet, p.ref, u))
        ds = ''
        for pr in findall(syms[p.lib_id], 'property'):
            if pr[1] == 'Datasheet':
                ds = str(pr[2])
        board.append(instance(p, x, y, r, path, '/%s/' % p.sheet, p.sheet + '.kicad_sch', ds))
    board += fiducials()
    ux, uy, _ = PLACE['U1']
    extra = finger_stubs(board) + rp_support(board, ux, uy)
    board += extra
    add_fanout(board, extra)
    board += outline()
    # the tab: fingers only -- no tracks, vias or pour on any layer (pads and the stubs allowed)
    tab = [(TAB_X0 - 0.5, PAD_TOP_Y + 0.5), (TAB_X1 + 0.5, PAD_TOP_Y + 0.5), (TAB_X1 + 0.5, Y1 + 1), (TAB_X0 - 0.5, Y1 + 1)]
    tab_all = [(TAB_X0 - 0.5, TAB_Y), (TAB_X1 + 0.5, TAB_Y), (TAB_X1 + 0.5, Y1 + 1), (TAB_X0 - 0.5, Y1 + 1)]
    for L in ('F.Cu', 'B.Cu'):
        board.append(zone('tab_fingers_only_' + L[0], None, L, tab, keepout=True))
    for L in ('In1.Cu', 'In2.Cu', 'In3.Cu', 'In4.Cu'):
        board.append(zone('tab_no_copper_' + L[2], None, L, tab_all, keepout=True))
    for L in ('F.Cu', 'B.Cu'):      # and no pour on the tab at all (the stubs may cross it)
        z = zone('tab_no_pour_' + L[0], None, L, tab_all, keepout=True)
        find(z, 'keepout')[1:] = [['tracks', 'allowed'], ['vias', 'allowed'], ['pads', 'allowed'],
                                  ['copperpour', 'not_allowed'], ['footprints', 'allowed']]
        board.append(z)
    board.append(zone('GND_plane', 'GND', 'In1.Cu', BODY))
    board.append(zone('3V3_plane', '+3V3', 'In4.Cu', BODY))
    board.append(text('Frob2354 Rev0', 147.5, 33.0, 'F.SilkS', 1.5))
    board.append(text('Apple II FROB card, RP2354B', 147.5, 35.4, 'F.SilkS', 1.0))
    board.append(text('Frob2354 Rev0  -  pin 1 front', XC, Y0 + 3.0, 'B.SilkS', 1.0, mirror=True))
    board.append(['embedded_fonts', 'no'])
    open(PCB, 'w').write(dump(board) + '\n')
    print('placed %d parts -> %s' % (len(D.PARTS), os.path.basename(PCB)))


if __name__ == '__main__':
    main()
