tschak909/frob-modern/hardware/tools/export.py

#!/usr/bin/env python3
"""Fabrication + documentation outputs for Frob2354 Rev0.

Always (from the schematic / design.py):
  Frob2354-BOM.csv                          full BOM (hand-soldered parts flagged)
  exports/jlcpcb/BOM-JLCPCB.csv             Comment,Designator,Footprint,LCSC Part # (assembled parts only)
  docs/Frob2354-schematic.pdf

Once Frob2354.kicad_pcb exists:
  exports/jlcpcb/CPL-JLCPCB.csv             Designator,Mid X,Mid Y,Layer,Rotation
  exports/jlcpcb/Frob2354-gerbers.zip       gerbers + Excellon drill
  docs/layout-front.svg, docs/layout-back.svg, docs/board-top.png, docs/board-bottom.png

CPL rotations: KiCad's footprint zero orientation differs from JLCPCB's for
some packages; JLC_ROT below holds the corrections (the widely used
kicad-jlcpcb-tools table for these footprints).  Always check the placement
preview on JLCPCB's order page before paying -- polarity marks, not
rotation numbers, are what matter.

Usage: python3 tools/export.py
"""
import csv, os, re, shutil, subprocess, sys, tempfile, zipfile
sys.path.insert(0, os.path.dirname(os.path.abspath(__file__)))
import design as D

HERE = os.path.dirname(os.path.abspath(__file__))
PRJ = os.path.dirname(HERE)
PCB = os.path.join(PRJ, D.PROJECT + '.kicad_pcb')
SCH = os.path.join(PRJ, D.PROJECT + '.kicad_sch')
OUT = os.path.join(PRJ, 'exports', 'jlcpcb')
DOCS = os.path.join(PRJ, 'docs')

JLC_ROT = [  # (footprint regex, degrees added to KiCad's rotation)
    (r'^SOT-23$', 180),
    (r'^SOT-23-5', 180),
    (r'^SOT-23-6', 180),
    (r'^QFN-', 270),
    (r'^TSSOP-', 270),
    (r'^USB_C_Receptacle_HRO_TYPE-C-31-M-12', 180),
    (r'^D_SMA', 180),
    (r'^R_Array_Convex_4x0603', 270),
]


def run(*a):
    r = subprocess.run(a, capture_output=True, text=True)
    if r.returncode:
        sys.stderr.write(r.stdout + r.stderr)
        raise SystemExit('failed: ' + ' '.join(a))
    return r.stdout


def boms():
    groups = {}
    for p in D.PARTS:
        if not p.bom:
            continue
        key = (p.value, p.footprint, p.mpn, p.lcsc, p.dnp)
        groups.setdefault(key, []).append(p)
    ref_key = lambda r: (re.sub(r'\d', '', r), int(re.sub(r'\D', '', r) or 0))
    rows = sorted(groups.items(), key=lambda kv: ref_key(kv[1][0].ref))
    with open(os.path.join(PRJ, D.PROJECT + '-BOM.csv'), 'w', newline='') as f:
        w = csv.writer(f, quoting=csv.QUOTE_ALL)
        w.writerow(['Refs', 'Value', 'Footprint', 'MPN', 'LCSC', 'Description', 'Assembly'])
        for (val, fp, mpn, lcsc, dnp), ps in rows:
            refs = ','.join(sorted((p.ref for p in ps), key=ref_key))
            how = 'DNP' if dnp else ('JLCPCB' if ps[0].jlc else 'hand-solder')
            w.writerow([refs, val, fp.split(':')[1], mpn, lcsc, ps[0].desc, how])
    with open(os.path.join(OUT, 'BOM-JLCPCB.csv'), 'w', newline='') as f:
        w = csv.writer(f)
        w.writerow(['Comment', 'Designator', 'Footprint', 'LCSC Part #'])
        for (val, fp, mpn, lcsc, dnp), ps in rows:
            if dnp or not ps[0].jlc:
                continue       # not assembled by JLCPCB (DNP / hand-soldered): not in the CPL either
            if not lcsc:
                raise SystemExit('no LCSC code for ' + ps[0].ref)
            w.writerow([val, ','.join(sorted((p.ref for p in ps), key=ref_key)), fp.split(':')[1], lcsc])
    return {p.ref for p in D.PARTS if p.bom and not p.dnp and p.jlc}


def cpl(bom_refs):
    tmp = os.path.join(tempfile.gettempdir(), 'frob2354-pos.csv')
    run('kicad-cli', 'pcb', 'export', 'pos', '--format', 'csv', '--units', 'mm', '--side', 'both',
        '--exclude-dnp', '-o', tmp, PCB)
    rows = list(csv.DictReader(open(tmp)))
    seen = set()
    with open(os.path.join(OUT, 'CPL-JLCPCB.csv'), 'w', newline='') as f:
        w = csv.writer(f)
        w.writerow(['Designator', 'Mid X', 'Mid Y', 'Layer', 'Rotation'])
        for r in rows:
            ref = r['Ref']
            if ref not in bom_refs:
                continue
            rot = float(r['Rot'])
            for pat, add in JLC_ROT:
                if re.search(pat, r['Package']):
                    rot += add
                    break
            w.writerow([ref, r['PosX'], r['PosY'], 'Top' if r['Side'] == 'top' else 'Bottom', '%g' % (rot % 360)])
            seen.add(ref)
    missing = bom_refs - seen
    if missing:
        raise SystemExit('BOM parts missing from the placement file: ' + ' '.join(sorted(missing)))
    return len(seen)


def gerbers():
    g = os.path.join(OUT, 'gerbers')
    shutil.rmtree(g, ignore_errors=True)
    os.makedirs(g)
    layers = 'F.Cu,In1.Cu,In2.Cu,In3.Cu,In4.Cu,B.Cu,F.Paste,B.Paste,F.SilkS,B.SilkS,F.Mask,B.Mask,Edge.Cuts'
    run('kicad-cli', 'pcb', 'export', 'gerbers', '--layers', layers, '--subtract-soldermask',
        '--no-protel-ext', '-o', g + '/', PCB)
    run('kicad-cli', 'pcb', 'export', 'drill', '--format', 'excellon', '--excellon-separate-th',
        '--generate-map', '--map-format', 'gerberx2', '-o', g + '/', PCB)
    zf = os.path.join(OUT, D.PROJECT + '-gerbers.zip')
    with zipfile.ZipFile(zf, 'w', zipfile.ZIP_DEFLATED) as z:
        for fn in sorted(os.listdir(g)):
            z.write(os.path.join(g, fn), fn)
    shutil.rmtree(g)
    return zf


def sch_docs():
    os.makedirs(DOCS, exist_ok=True)
    run('kicad-cli', 'sch', 'export', 'pdf', '-o', os.path.join(DOCS, D.PROJECT + '-schematic.pdf'), SCH)


def pcb_docs():
    run('kicad-cli', 'pcb', 'export', 'svg', '--layers', 'F.Cu,F.SilkS,F.Mask,Edge.Cuts', '--mode-single',
        '--fit-page-to-board', '-o', os.path.join(DOCS, 'layout-front.svg'), PCB)
    run('kicad-cli', 'pcb', 'export', 'svg', '--layers', 'B.Cu,B.SilkS,B.Mask,Edge.Cuts', '--mode-single',
        '--mirror', '--fit-page-to-board', '-o', os.path.join(DOCS, 'layout-back.svg'), PCB)
    for side, fn in (('top', 'board-top.png'), ('bottom', 'board-bottom.png')):
        run('kicad-cli', 'pcb', 'render', '--side', side, '--width', '1600', '--height', '1000',
            '--quality', 'high', '--background', 'opaque', '-o', os.path.join(DOCS, fn), PCB)


def main():
    os.makedirs(OUT, exist_ok=True)
    refs = boms()
    sch_docs()
    if not os.path.exists(PCB):
        print('BOM: %d placed refs; schematic PDF written. No %s yet: CPL, gerbers and layout '
              'renders skipped.' % (len(refs), os.path.basename(PCB)))
        return
    n = cpl(refs)
    zf = gerbers()
    pcb_docs()
    print('BOM: %d placed refs; CPL: %d rows; %s' % (len(refs), n, os.path.relpath(zf, PRJ)))


if __name__ == '__main__':
    main()
